nathanshaw/SNES_Circuit_Bending/README.md

Donkey KongCountry Circuit Bent

# SNES_Circuit_Bending
