nathanshaw/SNES_Circuit_Bending/snes_schematic_color.pdf

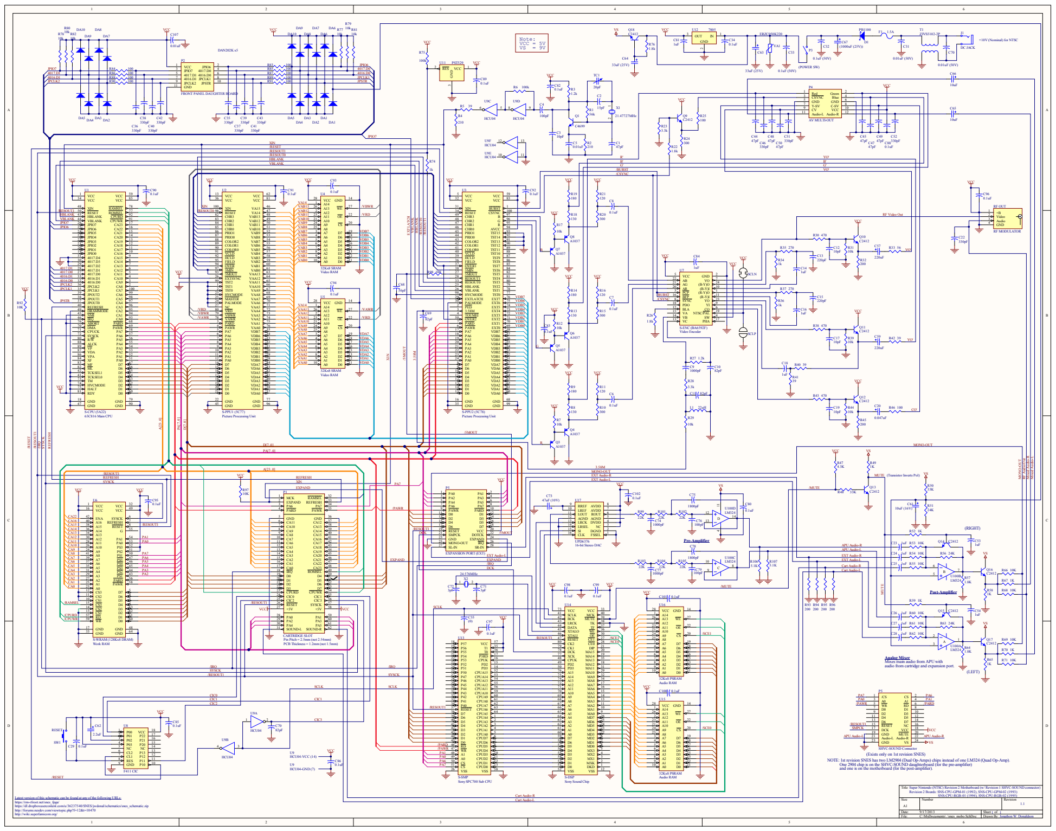
[picture p1: page 1]

Note:
+10V (Nominal) for NTSC VCC = aV VS = 9V

GND 11

FRONT PANEL DAUGHTER BOARD

CSYNC 3 Blue GND C-SV VCC Audio-R | 4
GND 5 | 6
Y-SV 7 | 8
CV 9 | 10
Audio-L 11 | 12

/RESET | | 10 11 U9E
/RESOUT1 | R74 1k
/RESOUT0

/CSYNC | RF Video Out

COLOR0 90 | VAB3 | A3 7 | VDB3

VCC | A[23..0] | MONO-OUT

R49 1K MUTE (Transistor Inverts Pol)

R71 10K Analog Mixer Mixes main audio from APU with audio from cartridge and expansion port.

SHVC-SOUND Connector
(Exists only on 1st revision SNES)

NOTE: 1st revision SNES has two LM2904 (Dual Op-Amps) chips instead of one LM324 (Quad Op-Amp). One 2904 chip is on the SHVC-SOUND daughterboard (for the pre-amplifier) and one is on the motherboard (for the post-amplifier).

Title
Super Nintendo (NTSC) Revision 2 Motherboard (w/ Revision 1 SHVC-SOUND connector)
Revision 2 Boards: SNS-CPU-GPM-01 (1992), SNS-CPU-GPM-02 (1993)

Latest version of this schematic can be found at any of the following URLs:
https://rm-rfroot.net/snes_fpga/
https://dl.dropboxusercontent.com/u/36237540/SNES/jwdonal/schematics/snes_schematic.zip
http://forums.nesdev.com/viewtopic.php?f=12at=10470
http://wiki.superfamicom.org/

SNS-CPU-RGB-01 (1994), SNS-CPU-RGB-02 (1995)
