nathanshaw/SNES_Circuit_Bending/CAD/modular_snes/nano_control_station.brd

## EAGLE design CAD/modular_snes/nano_control_station.brd (2015-11-13)

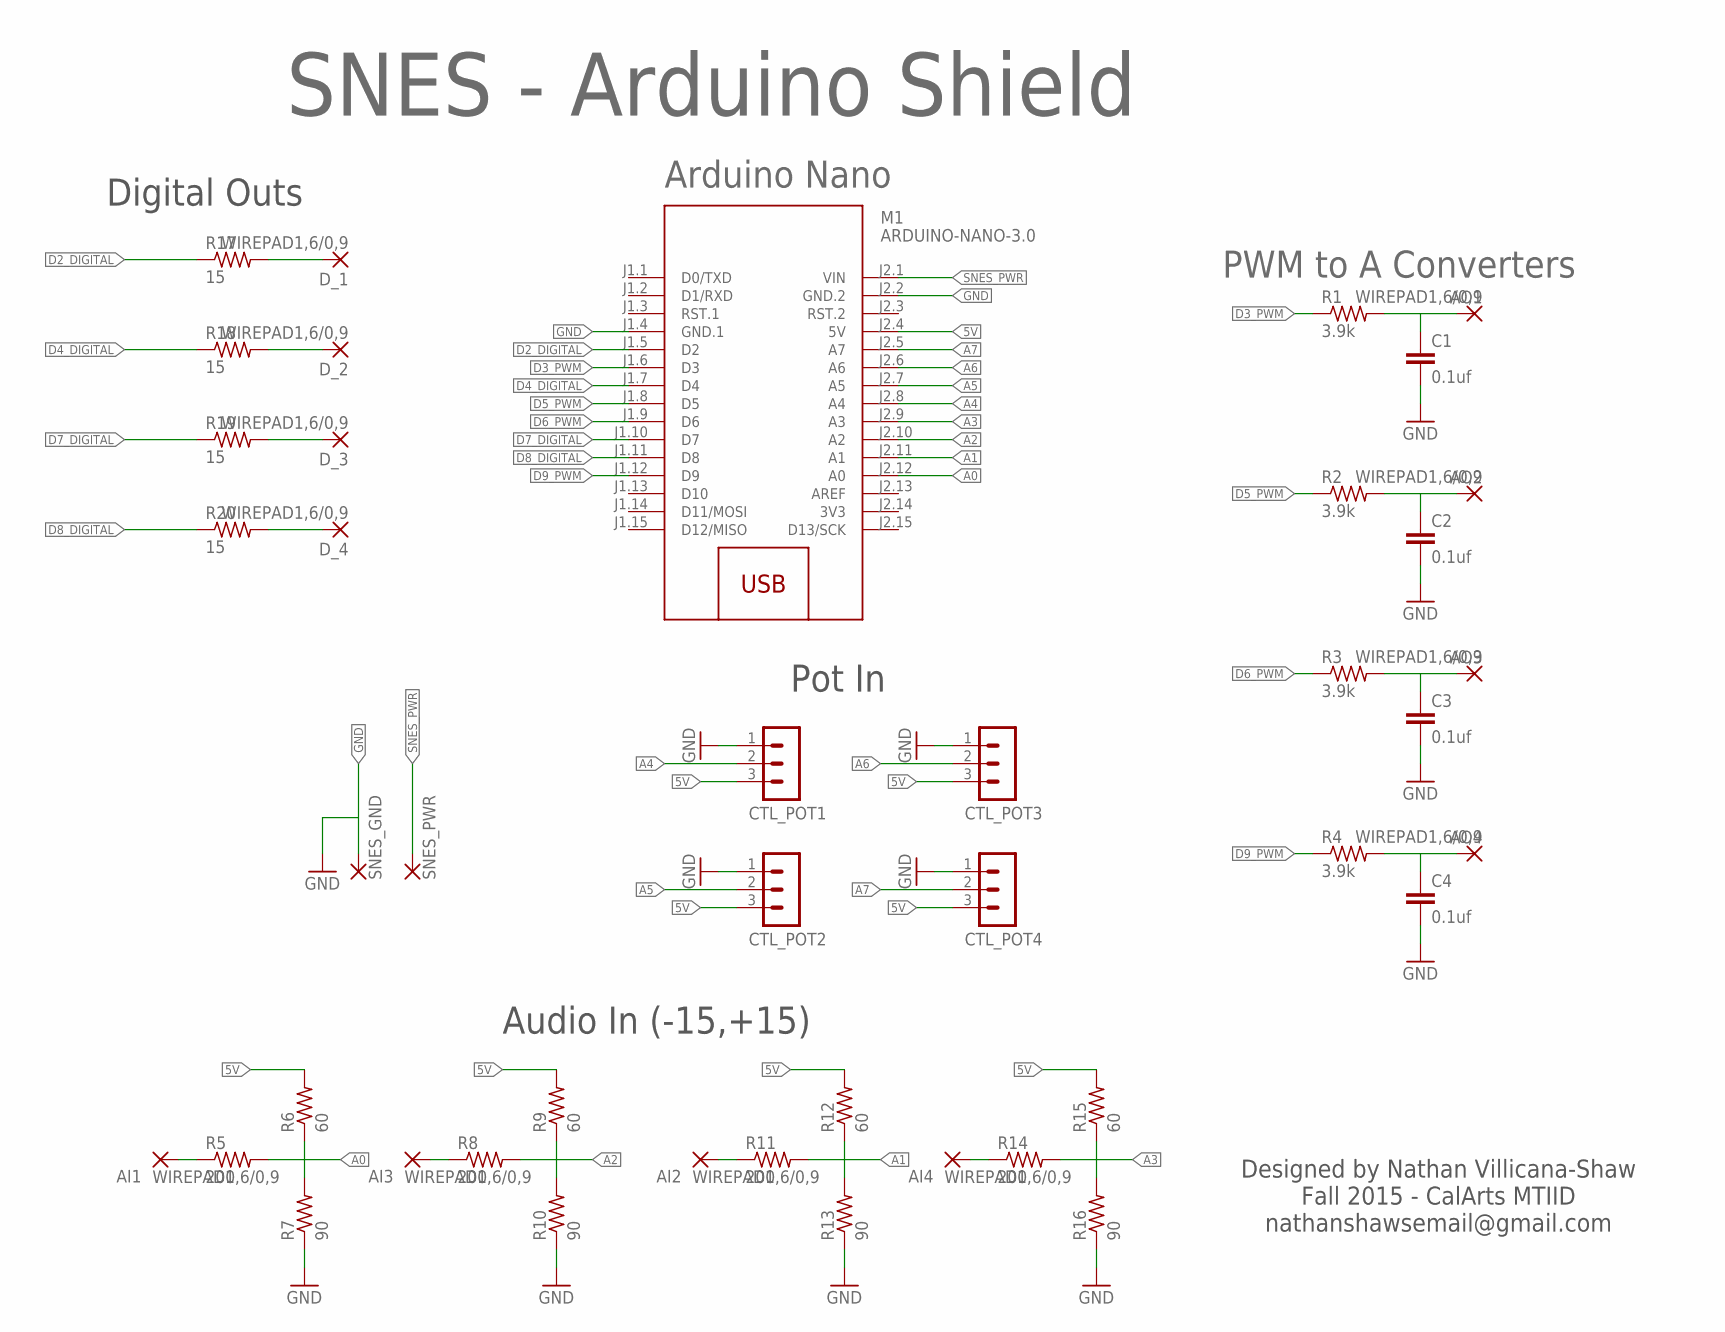
[picture p2: schematic nano_control_station.sch]

Parts:
AI1, AI2, AI3, AI4: WIREPAD1,6/0,9; 1,6/0,9
AO1, AO2, AO3, AO4: WIREPAD1,6/0,9; 1,6/0,9
C1, C2, C3, C4: 0.1uf; C2.5-2
CTL_POT1, CTL_POT2, CTL_POT3, CTL_POT4: MA03-1
D_1, D_2, D_3, D_4: WIREPAD1,6/0,9; 1,6/0,9
M1: ARDUINO-NANO-3.0
R1, R2, R3, R4: 3.9k; 0204/7
R5, R8, R11, R14: 200; 0204/7
R6, R9, R12, R15: 60; 0204/7
R7, R10, R13, R16: 90; 0204/7
R17, R18, R19, R20: 15; 0204/7
SNES_GND: 2,15/1,0
SNES_PWR: 2,15/1,0

Connections:
3V3: M1.J2.14 (3V3)
5V: CTL_POT1.3, CTL_POT2.3, CTL_POT3.3, CTL_POT4.3, M1.J2.4 (5V), R6.2, R9.2, R12.2, R15.2
A0: M1.J2.12 (A0), R5.2, R6.1, R7.2
A1: M1.J2.11 (A1), R11.2, R12.1, R13.2
A2: M1.J2.10 (A2), R8.2, R9.1, R10.2
A3: M1.J2.9 (A3), R14.2, R15.1, R16.2
A4: CTL_POT1.2, M1.J2.8 (A4)
A5: CTL_POT2.2, M1.J2.7 (A5)
A6: CTL_POT3.2, M1.J2.6 (A6)
A7: CTL_POT4.2, M1.J2.5 (A7)
D2_DIGITAL: M1.J1.5 (D2), R17.1
D3_PWM: M1.J1.6 (D3), R1.1
D4_DIGITAL: M1.J1.7 (D4), R18.1
D5_PWM: M1.J1.8 (D5), R2.1
D6_PWM: M1.J1.9 (D6), R3.1
D7_DIGITAL: M1.J1.10 (D7), R19.1
D8_DIGITAL: M1.J1.11 (D8), R20.1
D9_PWM: M1.J1.12 (D9), R4.1
GND: C1.2, C2.2, C3.2, C4.2, CTL_POT1.1, CTL_POT2.1, CTL_POT3.1, CTL_POT4.1, M1.J1.4 (GND.1), M1.J2.2 (GND.2), R7.1, R10.1, R13.1, R16.1, SNES_GND.1
unnamed: AI3.1, R8.1
unnamed: AO1.1, C1.1, R1.2
unnamed: AO2.1, C2.1, R2.2
unnamed: AO3.1, C3.1, R3.2
unnamed: AO4.1, C4.1, R4.2
unnamed: AI1.1, R5.1
unnamed: AI2.1, R11.1
unnamed: AI4.1, R14.1
unnamed: D_2.1, R18.2
unnamed: D_1.1, R17.2
unnamed: D_3.1, R19.2
unnamed: D_4.1, R20.2
SNES_PWR: M1.J2.1 (VIN), SNES_PWR.1

Notes on the sheet:
PWM to A Converters
Audio In (-15,+15)
Digital Outs
Pot In
Arduino Nano
SNES - Arduino Shield
Designed by Nathan Villicana-Shaw Fall 2015 - CalArts MTIID nathanshawsemail@gmail.com

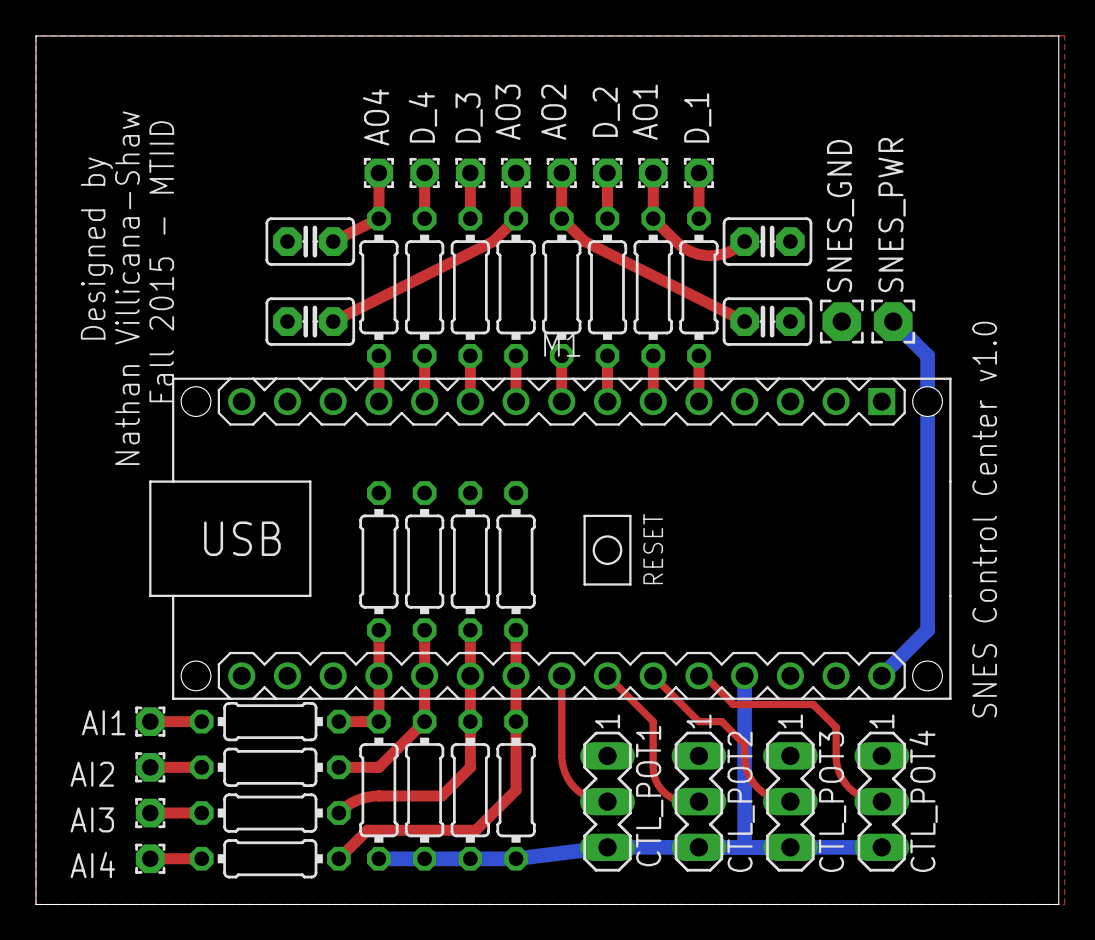
[picture p3: board nano_control_station.brd from above]

Board: 2 copper layers, 56.8 x 48.2 mm, 43 parts (0 on the bottom side), 31 nets.
