nathanshaw/SNES_Circuit_Bending/CAD/Ultimate_Co_Op_Mega_Shield/ultimate_Co-Op_v2_0.brd

## EAGLE design CAD/Ultimate_Co_Op_Mega_Shield/ultimate_Co-Op_v2_0.brd (2016-02-03)

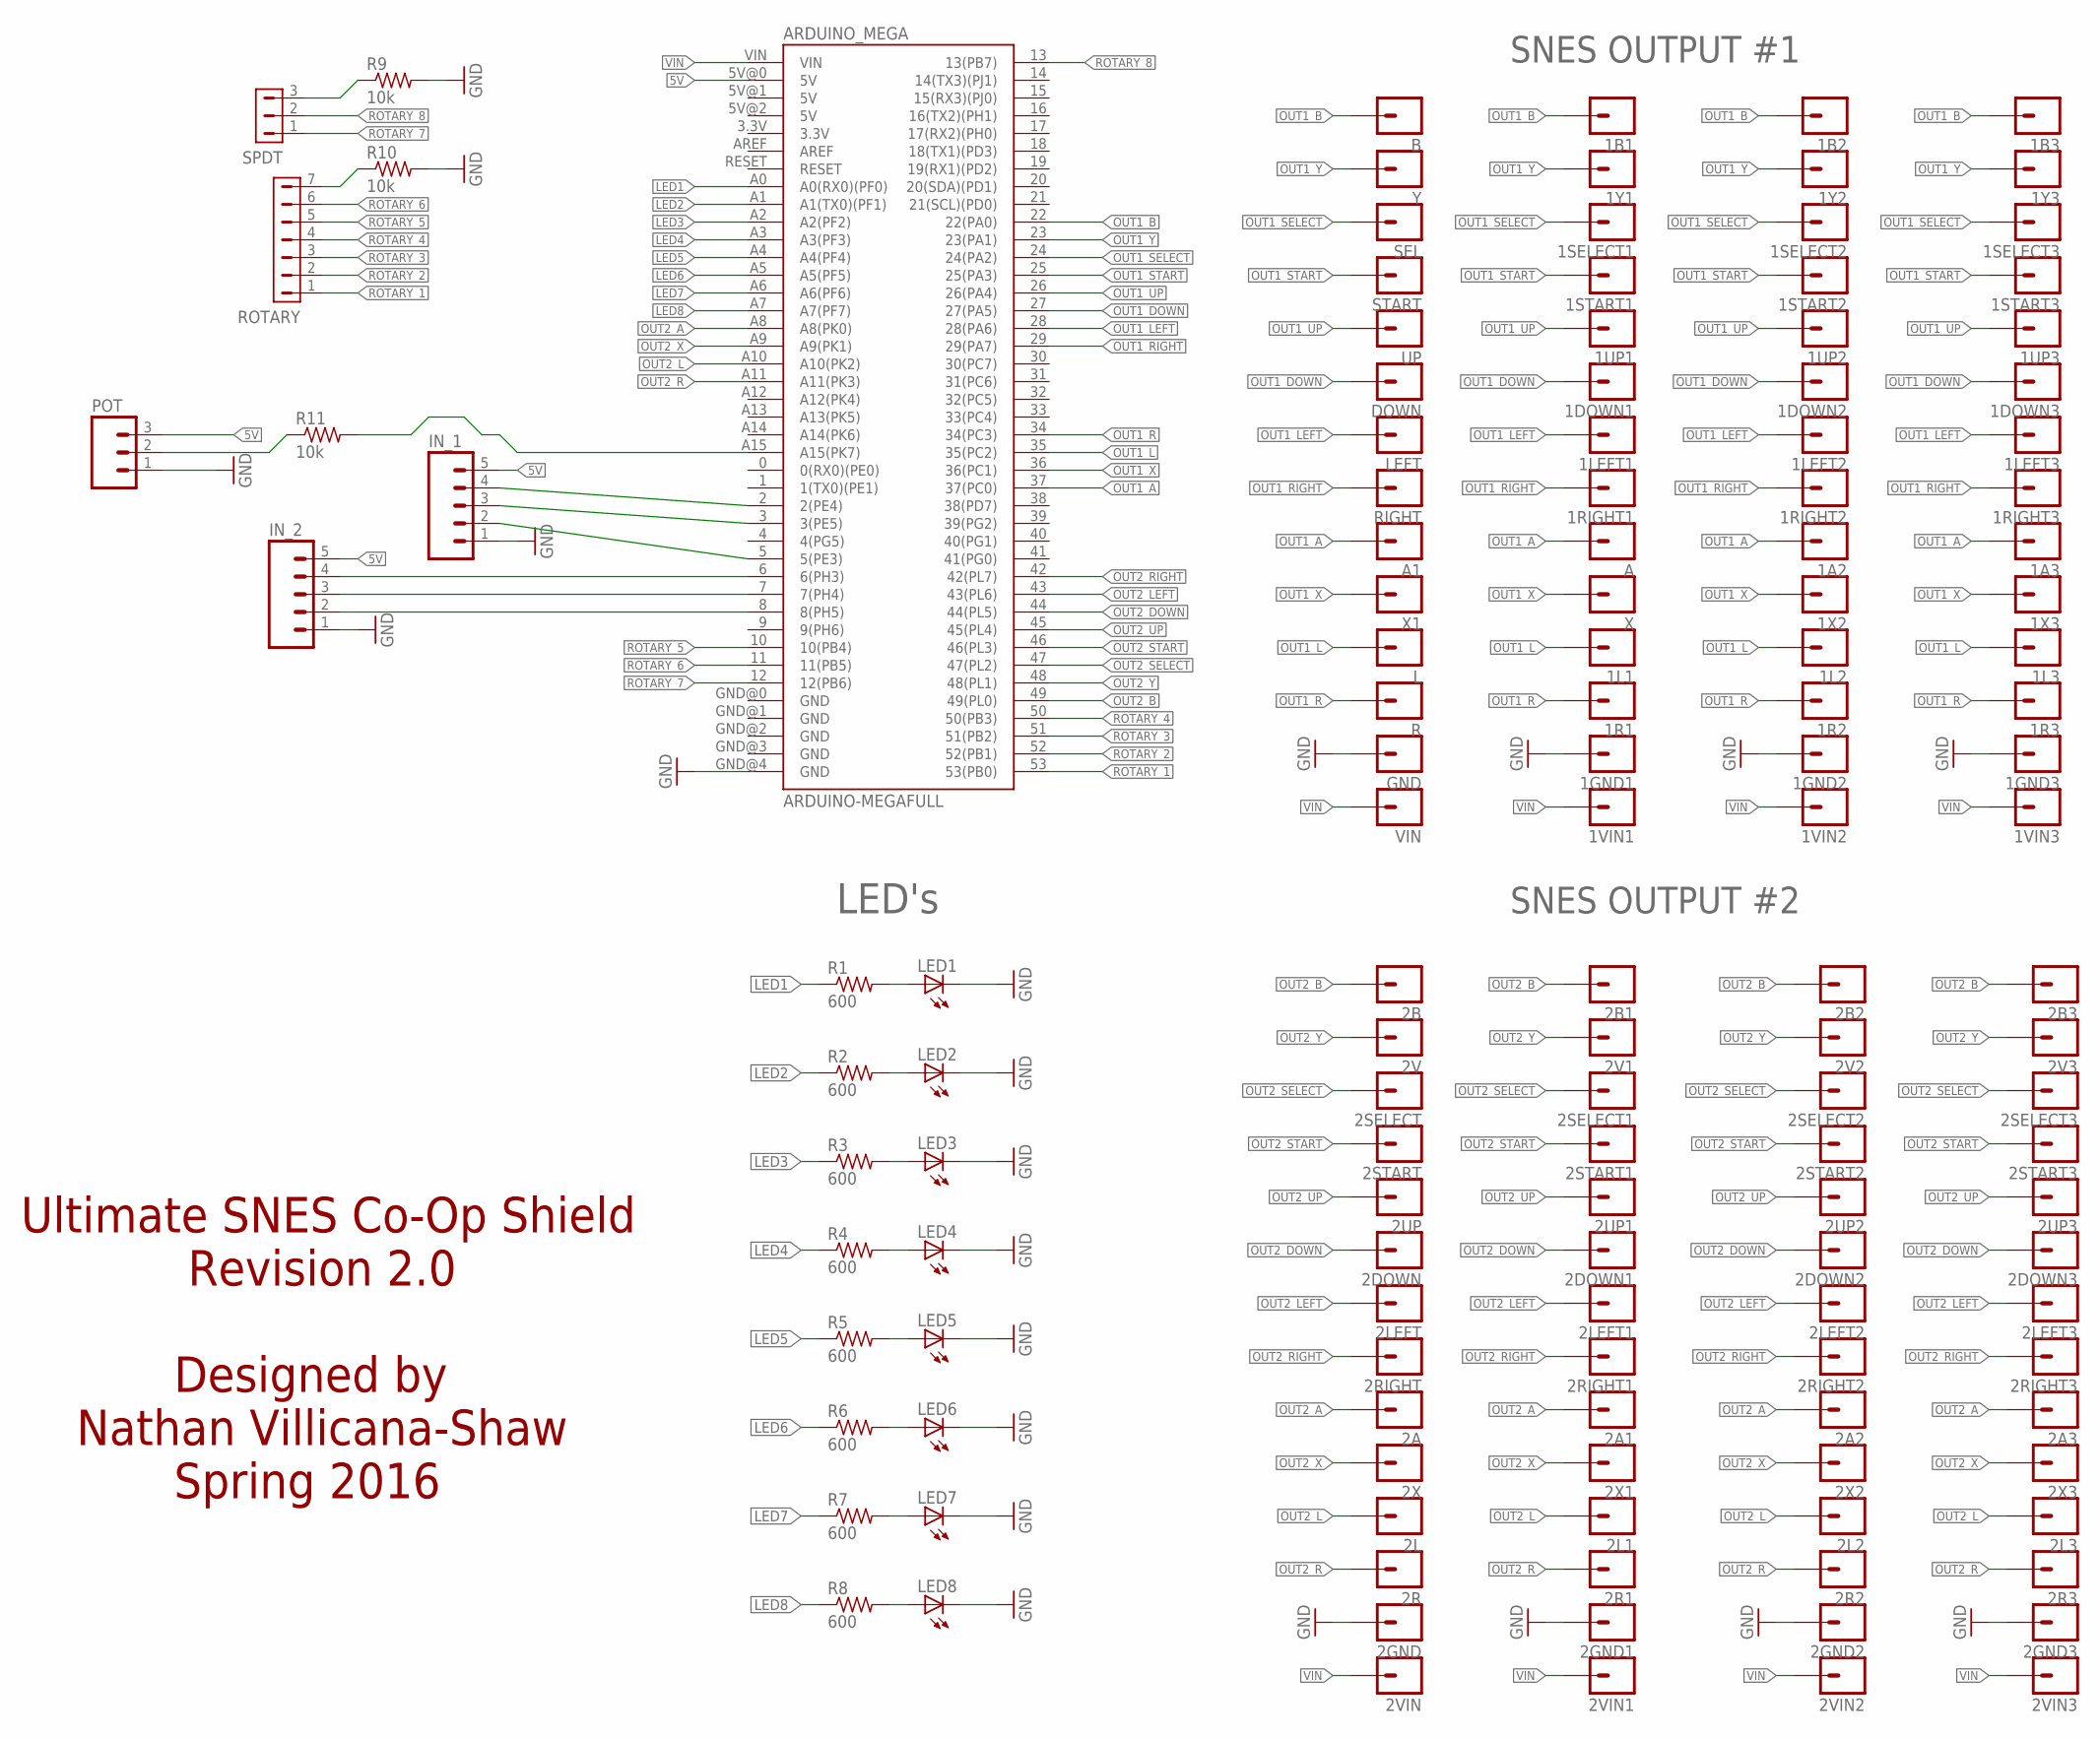
[picture p4: schematic ultimate_Co-Op_v2_0.sch]

Parts:
1A2, 1A3, 1B1, 1B2, 1B3, 1DOWN1, 1DOWN2, 1DOWN3, 1GND1, 1GND2, 1GND3, 1L1, 1L2, 1L3, 1LEFT1, 1LEFT2, 1LEFT3, 1R1, 1R2, 1R3, 1RIGHT1, 1RIGHT2, 1RIGHT3, 1SELECT1, 1SELECT2, 1SELECT3, 1START1, 1START2, 1START3, 1UP1, 1UP2, 1UP3, 1VIN1, 1VIN2, 1VIN3, 1X2, 1X3, 1Y1, 1Y2, 1Y3, 2A, 2A1, 2A2, 2A3, 2B, 2B1, 2B2, 2B3, 2DOWN, 2DOWN1, 2DOWN2, 2DOWN3, 2GND, 2GND1, 2GND2, 2GND3, 2L, 2L1, 2L2, 2L3, 2LEFT, 2LEFT1, 2LEFT2, 2LEFT3, 2R, 2R1, 2R2, 2R3, 2RIGHT, 2RIGHT1, 2RIGHT2, 2RIGHT3, 2SELECT, 2SELECT1, 2SELECT2, 2SELECT3, 2START, 2START1, 2START2, 2START3, 2UP, 2UP1, 2UP2, 2UP3, 2V, 2V1, 2V2, 2V3, 2VIN, 2VIN1, 2VIN2, 2VIN3, 2X, 2X1, 2X2, 2X3: M01PTH; 1X01
A, A1: M01PTH; 1X01
ARDUINO_MEGA: ARDUINO-MEGAFULL; ARDUINO_MEGA
B: M01PTH; 1X01
DOWN: M01PTH; 1X01
GND: M01PTH; 1X01
IN_1, IN_2: M05PTH; 1X05
L: M01PTH; 1X01
LED1, LED2, LED3, LED4, LED5, LED6, LED7, LED8: LED5MM
LEFT: M01PTH; 1X01
POT: M03LONGPADS; 1X03_LONGPADS
R: M01PTH; 1X01
R1, R2, R3, R4, R5, R6, R7, R8: 600; 0204/7
R9, R10, R11: 10k; 0204/7
RIGHT: M01PTH; 1X01
ROTARY: HDR-1X7-MTE-100; MTE-100-7V
SEL: M01PTH; 1X01
SPDT: HDR-1X3-MTA-100; MTA-100-3V
START: M01PTH; 1X01
UP: M01PTH; 1X01
VIN: M01PTH; 1X01
X, X1: M01PTH; 1X01
Y: M01PTH; 1X01

Connections:
5V: ARDUINO_MEGA.5V@0 (5V), IN_1.5, IN_2.5, POT.3
GND: 1GND1.1, 1GND2.1, 1GND3.1, 2GND.1, 2GND1.1, 2GND2.1, 2GND3.1, ARDUINO_MEGA.GND@4 (GND), GND.1, IN_1.1, IN_2.1, LED1.K (C), LED2.K (C), LED3.K (C), LED4.K (C), LED5.K (C), LED6.K (C), LED7.K (C), LED8.K (C), POT.1, R9.2, R10.2
LED1: ARDUINO_MEGA.A0 (A0(RX0)(PF0)), R1.1
LED2: ARDUINO_MEGA.A1 (A1(TX0)(PF1)), R2.1
LED3: ARDUINO_MEGA.A2 (A2(PF2)), R3.1
LED4: ARDUINO_MEGA.A3 (A3(PF3)), R4.1
LED5: ARDUINO_MEGA.A4 (A4(PF4)), R5.1
LED6: ARDUINO_MEGA.A5 (A5(PF5)), R6.1
LED7: ARDUINO_MEGA.A6 (A6(PF6)), R7.1
LED8: ARDUINO_MEGA.A7 (A7(PF7)), R8.1
LSJDFKS: ARDUINO_MEGA.6 (6(PH3)), IN_2.4
unnamed: LED1.A, R1.2
unnamed: LED2.A, R2.2
unnamed: LED3.A, R3.2
unnamed: LED4.A, R4.2
unnamed: LED5.A, R5.2
unnamed: LED6.A, R6.2
unnamed: LED7.A, R7.2
unnamed: LED8.A, R8.2
unnamed: ARDUINO_MEGA.2 (2(PE4)), IN_1.4
unnamed: ARDUINO_MEGA.3 (3(PE5)), IN_1.3
unnamed: ARDUINO_MEGA.5 (5(PE3)), IN_1.2
unnamed: ARDUINO_MEGA.A15 (A15(PK7)), R11.2
unnamed: ARDUINO_MEGA.7 (7(PH4)), IN_2.3
unnamed: ARDUINO_MEGA.8 (8(PH5)), IN_2.2
unnamed: POT.2, R11.1
OIJNENLK: R9.1, SPDT.3
OIJNENLK1: R10.1, ROTARY.7
OUT1_A: 1A2.1, 1A3.1, A.1, A1.1, ARDUINO_MEGA.37 (37(PC0))
OUT1_B: 1B1.1, 1B2.1, 1B3.1, ARDUINO_MEGA.22 (22(PA0)), B.1
OUT1_DOWN: 1DOWN1.1, 1DOWN2.1, 1DOWN3.1, ARDUINO_MEGA.27 (27(PA5)), DOWN.1
OUT1_L: 1L1.1, 1L2.1, 1L3.1, ARDUINO_MEGA.35 (35(PC2)), L.1
OUT1_LEFT: 1LEFT1.1, 1LEFT2.1, 1LEFT3.1, ARDUINO_MEGA.28 (28(PA6)), LEFT.1
OUT1_R: 1R1.1, 1R2.1, 1R3.1, ARDUINO_MEGA.34 (34(PC3)), R.1
OUT1_RIGHT: 1RIGHT1.1, 1RIGHT2.1, 1RIGHT3.1, ARDUINO_MEGA.29 (29(PA7)), RIGHT.1
OUT1_SELECT: 1SELECT1.1, 1SELECT2.1, 1SELECT3.1, ARDUINO_MEGA.24 (24(PA2)), SEL.1
OUT1_START: 1START1.1, 1START2.1, 1START3.1, ARDUINO_MEGA.25 (25(PA3)), START.1
OUT1_UP: 1UP1.1, 1UP2.1, 1UP3.1, ARDUINO_MEGA.26 (26(PA4)), UP.1
OUT1_X: 1X2.1, 1X3.1, ARDUINO_MEGA.36 (36(PC1)), X.1, X1.1
OUT1_Y: 1Y1.1, 1Y2.1, 1Y3.1, ARDUINO_MEGA.23 (23(PA1)), Y.1
OUT2_A: 2A.1, 2A1.1, 2A2.1, 2A3.1, ARDUINO_MEGA.A8 (A8(PK0))
OUT2_B: 2B.1, 2B1.1, 2B2.1, 2B3.1, ARDUINO_MEGA.49 (49(PL0))
OUT2_DOWN: 2DOWN.1, 2DOWN1.1, 2DOWN2.1, 2DOWN3.1, ARDUINO_MEGA.44 (44(PL5))
OUT2_L: 2L.1, 2L1.1, 2L2.1, 2L3.1, ARDUINO_MEGA.A10 (A10(PK2))
OUT2_LEFT: 2LEFT.1, 2LEFT1.1, 2LEFT2.1, 2LEFT3.1, ARDUINO_MEGA.43 (43(PL6))
OUT2_R: 2R.1, 2R1.1, 2R2.1, 2R3.1, ARDUINO_MEGA.A11 (A11(PK3))
OUT2_RIGHT: 2RIGHT.1, 2RIGHT1.1, 2RIGHT2.1, 2RIGHT3.1, ARDUINO_MEGA.42 (42(PL7))
OUT2_SELECT: 2SELECT.1, 2SELECT1.1, 2SELECT2.1, 2SELECT3.1, ARDUINO_MEGA.47 (47(PL2))
OUT2_START: 2START.1, 2START1.1, 2START2.1, 2START3.1, ARDUINO_MEGA.46 (46(PL3))
OUT2_UP: 2UP.1, 2UP1.1, 2UP2.1, 2UP3.1, ARDUINO_MEGA.45 (45(PL4))
OUT2_X: 2X.1, 2X1.1, 2X2.1, 2X3.1, ARDUINO_MEGA.A9 (A9(PK1))
OUT2_Y: 2V.1, 2V1.1, 2V2.1, 2V3.1, ARDUINO_MEGA.48 (48(PL1))
ROTARY_1: ARDUINO_MEGA.53 (53(PB0)), ROTARY.1
ROTARY_2: ARDUINO_MEGA.52 (52(PB1)), ROTARY.2
ROTARY_3: ARDUINO_MEGA.51 (51(PB2)), ROTARY.3
ROTARY_4: ARDUINO_MEGA.50 (50(PB3)), ROTARY.4
ROTARY_5: ARDUINO_MEGA.10 (10(PB4)), ROTARY.5
ROTARY_6: ARDUINO_MEGA.11 (11(PB5)), ROTARY.6
ROTARY_7: ARDUINO_MEGA.12 (12(PB6)), SPDT.1
ROTARY_8: ARDUINO_MEGA.13 (13(PB7)), SPDT.2
VIN: 1VIN1.1, 1VIN2.1, 1VIN3.1, 2VIN.1, 2VIN1.1, 2VIN2.1, 2VIN3.1, ARDUINO_MEGA.VIN, VIN.1

Notes on the sheet:
LED's
SNES OUTPUT #1
SNES OUTPUT #2
Ultimate SNES Co-Op Shield Revision 2.0 Designed by Nathan Villicana-Shaw Spring 2016

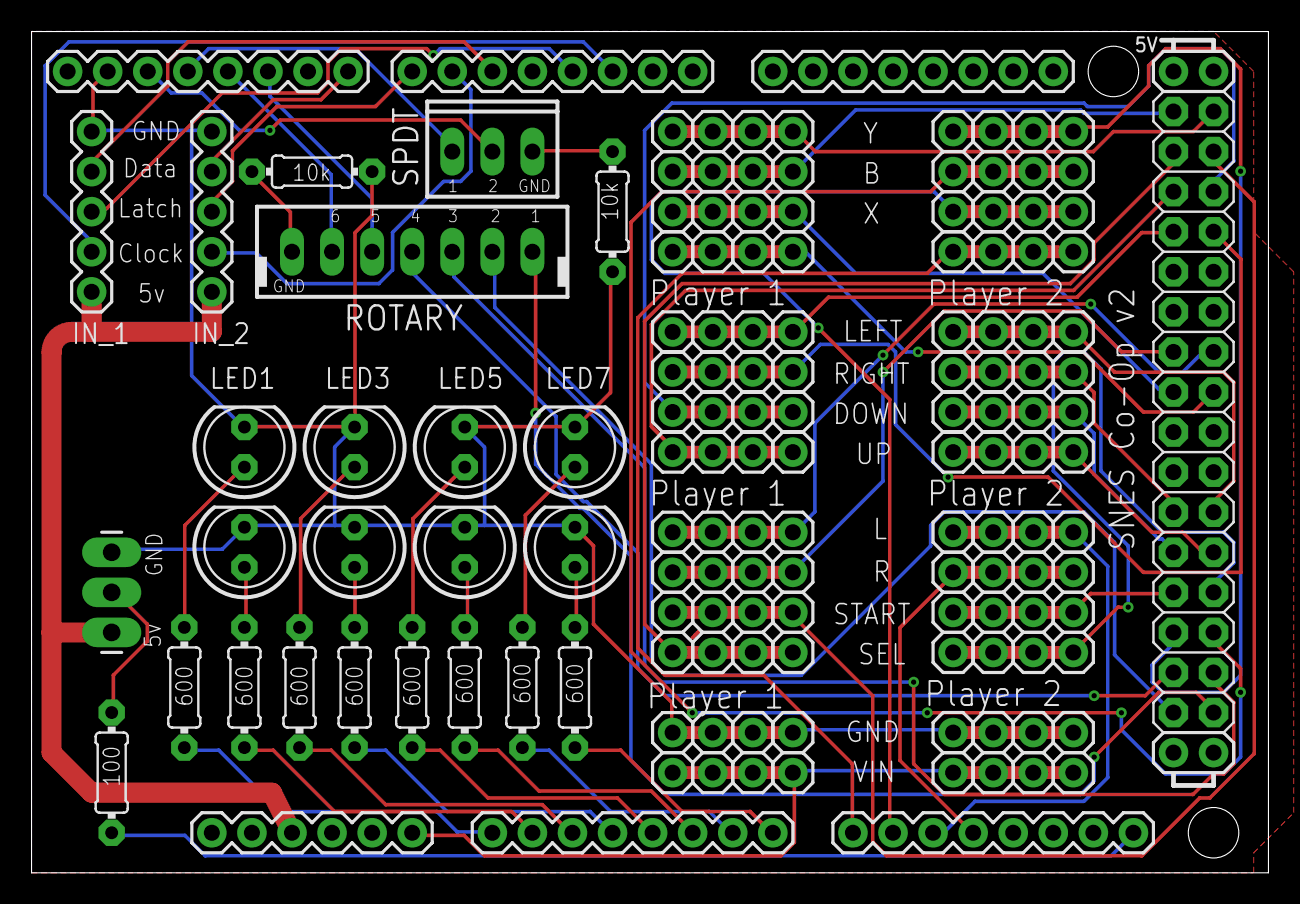
[picture p5: board ultimate_Co-Op_v2_0.brd from above]

Board: 2 copper layers, 78.4 x 53.3 mm, 137 parts (0 on the bottom side), 61 nets.
