nathanshaw/SNES_Circuit_Bending/CAD/Ultimate_Co_Op_Mega_Shield/ultimate_Co-Op_v1_0.brd

## EAGLE design CAD/Ultimate_Co_Op_Mega_Shield/ultimate_Co-Op_v1_0.brd (2016-01-06, an earlier design)

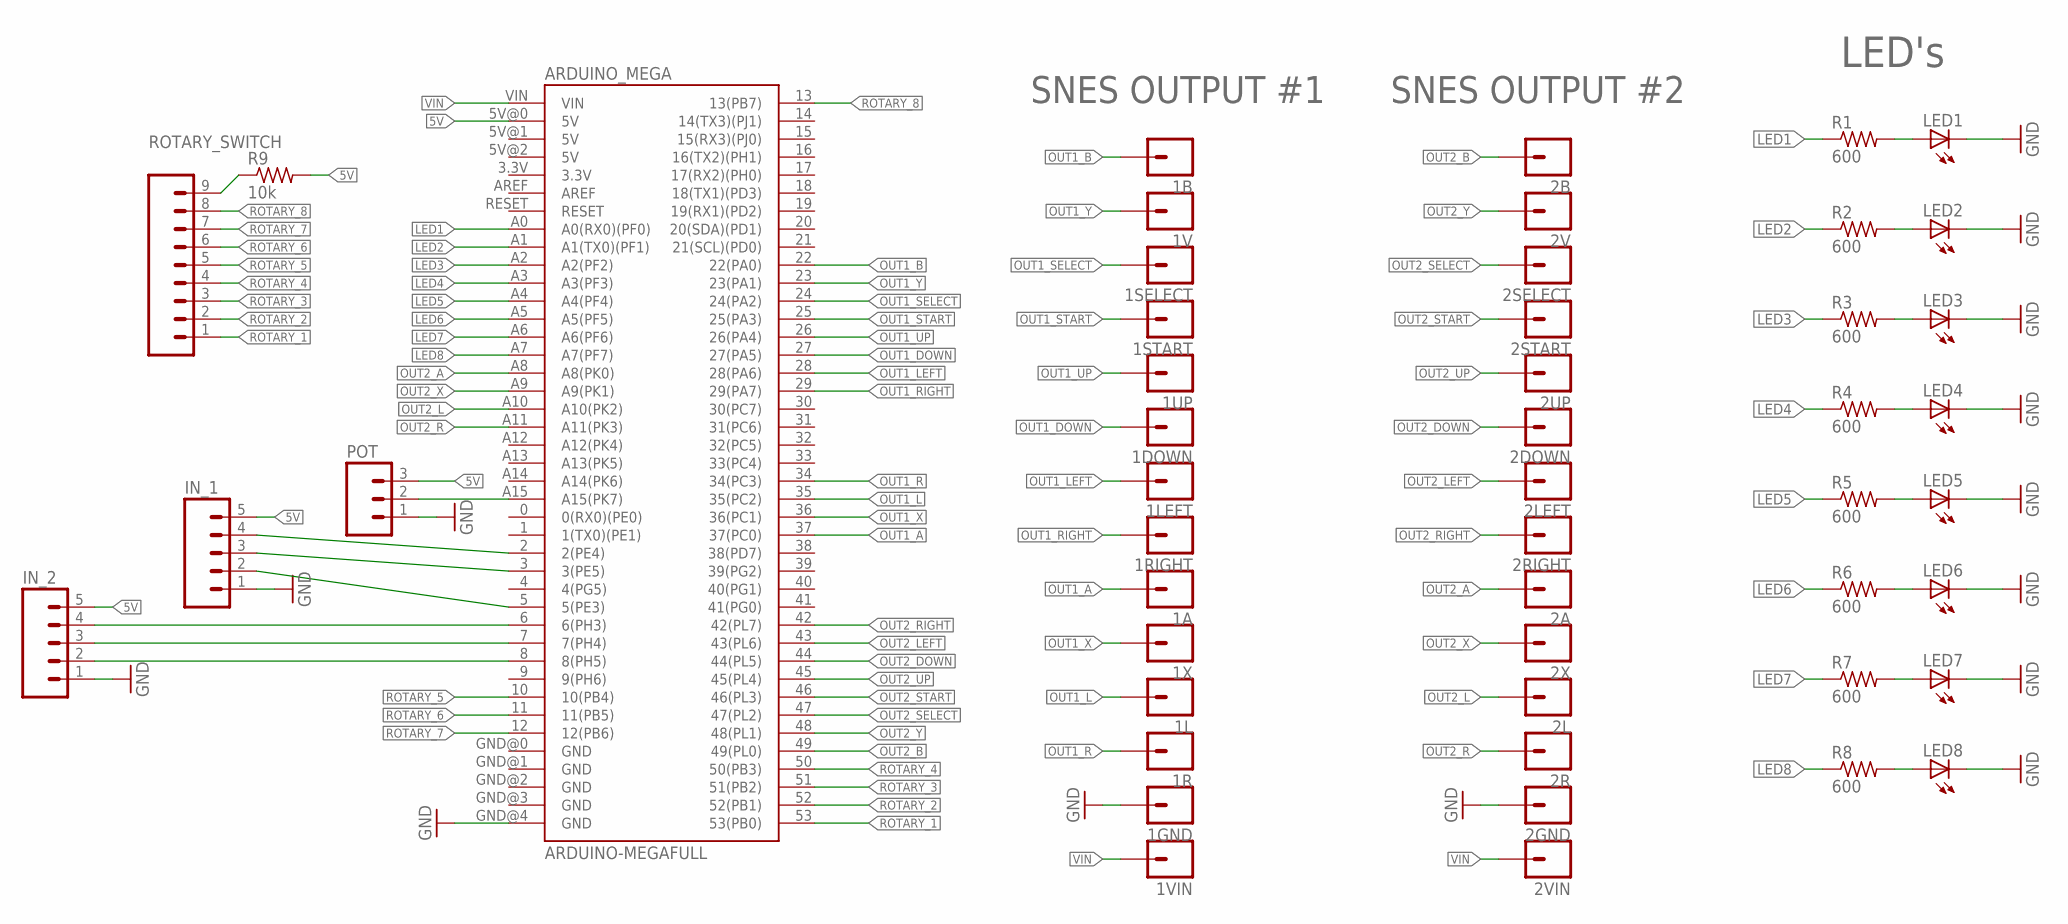
[picture p6: schematic ultimate_Co-Op_v1_0.sch]

Parts:
1A, 1B, 1DOWN, 1GND, 1L, 1LEFT, 1R, 1RIGHT, 1SELECT, 1START, 1UP, 1V, 1VIN, 1X, 2A, 2B, 2DOWN, 2GND, 2L, 2LEFT, 2R, 2RIGHT, 2SELECT, 2START, 2UP, 2V, 2VIN, 2X: M01PTH; 1X01
ARDUINO_MEGA: ARDUINO-MEGAFULL; ARDUINO_MEGA
IN_1, IN_2: M05PTH; 1X05
LED1, LED2, LED3, LED4, LED5, LED6, LED7, LED8: LED5MM
POT: M03LONGPADS; 1X03_LONGPADS
R1, R2, R3, R4, R5, R6, R7, R8: 600; 0204/7
R9: 10k; 0204/7
ROTARY_SWITCH: M09; 1X09

Connections:
5V: ARDUINO_MEGA.5V@0 (5V), IN_1.5, IN_2.5, POT.3, R9.2
GND: 1GND.1, 2GND.1, ARDUINO_MEGA.GND@4 (GND), IN_1.1, IN_2.1, LED1.K (C), LED2.K (C), LED3.K (C), LED4.K (C), LED5.K (C), LED6.K (C), LED7.K (C), LED8.K (C), POT.1
LED1: ARDUINO_MEGA.A0 (A0(RX0)(PF0)), R1.1
LED2: ARDUINO_MEGA.A1 (A1(TX0)(PF1)), R2.1
LED3: ARDUINO_MEGA.A2 (A2(PF2)), R3.1
LED4: ARDUINO_MEGA.A3 (A3(PF3)), R4.1
LED5: ARDUINO_MEGA.A4 (A4(PF4)), R5.1
LED6: ARDUINO_MEGA.A5 (A5(PF5)), R6.1
LED7: ARDUINO_MEGA.A6 (A6(PF6)), R7.1
LED8: ARDUINO_MEGA.A7 (A7(PF7)), R8.1
LSJDFKS: ARDUINO_MEGA.6 (6(PH3)), IN_2.4
unnamed: LED1.A, R1.2
unnamed: LED2.A, R2.2
unnamed: LED3.A, R3.2
unnamed: LED4.A, R4.2
unnamed: LED5.A, R5.2
unnamed: LED6.A, R6.2
unnamed: LED7.A, R7.2
unnamed: LED8.A, R8.2
unnamed: ARDUINO_MEGA.2 (2(PE4)), IN_1.4
unnamed: ARDUINO_MEGA.3 (3(PE5)), IN_1.3
unnamed: ARDUINO_MEGA.5 (5(PE3)), IN_1.2
unnamed: ARDUINO_MEGA.7 (7(PH4)), IN_2.3
unnamed: ARDUINO_MEGA.8 (8(PH5)), IN_2.2
OIJNENLK: R9.1, ROTARY_SWITCH.9
OUT1_A: 1A.1, ARDUINO_MEGA.37 (37(PC0))
OUT1_B: 1B.1, ARDUINO_MEGA.22 (22(PA0))
OUT1_DOWN: 1DOWN.1, ARDUINO_MEGA.27 (27(PA5))
OUT1_L: 1L.1, ARDUINO_MEGA.35 (35(PC2))
OUT1_LEFT: 1LEFT.1, ARDUINO_MEGA.28 (28(PA6))
OUT1_R: 1R.1, ARDUINO_MEGA.34 (34(PC3))
OUT1_RIGHT: 1RIGHT.1, ARDUINO_MEGA.29 (29(PA7))
OUT1_SELECT: 1SELECT.1, ARDUINO_MEGA.24 (24(PA2))
OUT1_START: 1START.1, ARDUINO_MEGA.25 (25(PA3))
OUT1_UP: 1UP.1, ARDUINO_MEGA.26 (26(PA4))
OUT1_X: 1X.1, ARDUINO_MEGA.36 (36(PC1))
OUT1_Y: 1V.1, ARDUINO_MEGA.23 (23(PA1))
OUT2_A: 2A.1, ARDUINO_MEGA.A8 (A8(PK0))
OUT2_B: 2B.1, ARDUINO_MEGA.49 (49(PL0))
OUT2_DOWN: 2DOWN.1, ARDUINO_MEGA.44 (44(PL5))
OUT2_L: 2L.1, ARDUINO_MEGA.A10 (A10(PK2))
OUT2_LEFT: 2LEFT.1, ARDUINO_MEGA.43 (43(PL6))
OUT2_R: 2R.1, ARDUINO_MEGA.A11 (A11(PK3))
OUT2_RIGHT: 2RIGHT.1, ARDUINO_MEGA.42 (42(PL7))
OUT2_SELECT: 2SELECT.1, ARDUINO_MEGA.47 (47(PL2))
OUT2_START: 2START.1, ARDUINO_MEGA.46 (46(PL3))
OUT2_UP: 2UP.1, ARDUINO_MEGA.45 (45(PL4))
OUT2_X: 2X.1, ARDUINO_MEGA.A9 (A9(PK1))
OUT2_Y: 2V.1, ARDUINO_MEGA.48 (48(PL1))
POT1: ARDUINO_MEGA.A15 (A15(PK7)), POT.2
ROTARY_1: ARDUINO_MEGA.53 (53(PB0)), ROTARY_SWITCH.1
ROTARY_2: ARDUINO_MEGA.52 (52(PB1)), ROTARY_SWITCH.2
ROTARY_3: ARDUINO_MEGA.51 (51(PB2)), ROTARY_SWITCH.3
ROTARY_4: ARDUINO_MEGA.50 (50(PB3)), ROTARY_SWITCH.4
ROTARY_5: ARDUINO_MEGA.10 (10(PB4)), ROTARY_SWITCH.5
ROTARY_6: ARDUINO_MEGA.11 (11(PB5)), ROTARY_SWITCH.6
ROTARY_7: ARDUINO_MEGA.12 (12(PB6)), ROTARY_SWITCH.7
ROTARY_8: ARDUINO_MEGA.13 (13(PB7)), ROTARY_SWITCH.8
VIN: 1VIN.1, 2VIN.1, ARDUINO_MEGA.VIN

Notes on the sheet:
LED's
SNES OUTPUT #1
SNES OUTPUT #2

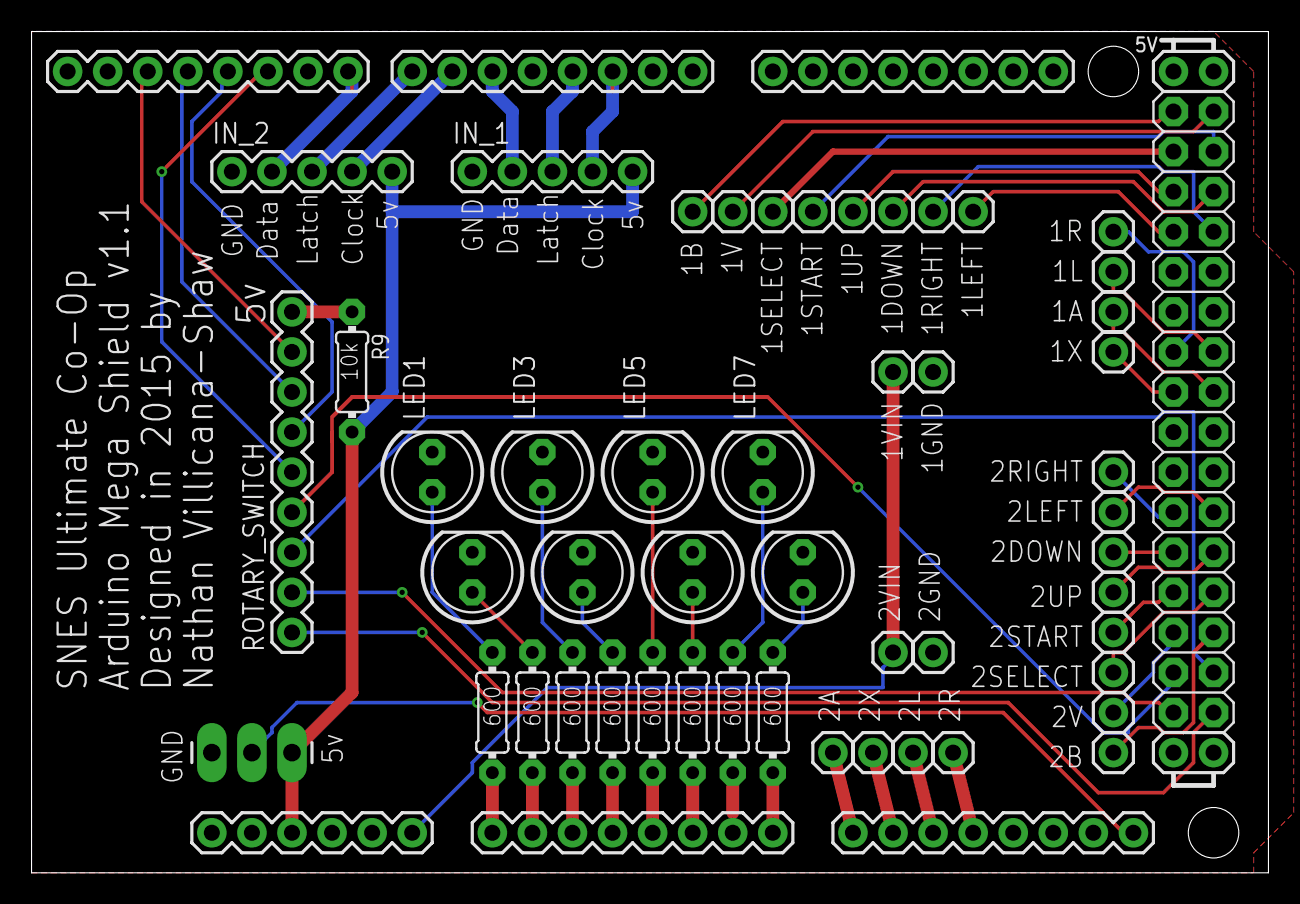
[picture p7: board ultimate_Co-Op_v1_0.brd from above]

Board: 2 copper layers, 78.4 x 53.3 mm, 50 parts (0 on the bottom side), 59 nets.
