nathanshaw/SNES_Circuit_Bending/Firmware/ultimate_co_op_Single_mode/ultimate_co_op_Single_mode.ino

/*
    Arduino Firmware for interfacing with the SNES

    Two Input Controllers : Two Output Controllers

    Programmed by Nathan Villicana-Shaw
    Fall 2015

    This project is a work in progress and builds upon the shoulders
    of many brilliant programmers, hackers, engineers and artists
    (links to be added soon)

    This specific version is for use with the Arduino Shield V1.1
    All the pinouts used in this configuration will be inside the () next to
    the normal values


    ===========================================================
    ARDUINO : PORTS AND PINS
    ===========================================================

    -------------------------------------------------
    PLAYER 1 : INPUT
    -------------------------------------------------
    GND
    5v
    DATA          5
    LATCH         3
    CLOCK         2
    -------------------------------------------------
    PLAYER 2 : INPUT
    -------------------------------------------------
    GND
    5v
    DATA          8
    LATCH         7
    CLOCK         6
    -------------------------------------------------
    PLAYER 1 : OUTPUT
    -------------------------------------------------
    PORTA on the Arduino Mega consists of pins 22-29
      22 is bit 0, 29 is bit 7
      we use all the pins  (11111111)

    PORTC on the Arduino MEGA consists of pins 30-37
    `37 is bit 0, 30 is bit 7
      we use pins 34-37 (xxxx1111)

    --------------------------------------------------
    PLAYER 2 : OUTPUT
    -------------------------------------------------
    PORTL : on the Arduino Mega consists of pins 42-49
      49 is bit 0, 42 is bit 7
      we use all the pins (11111111)

    PORTK : on the Arduino Mega consists of analog pins a8-a15
      a8 is bit 0, a15 is bit 7
      we use pins a8-a15 (xxxx1111)

    --------------------------------------------------
    LEDS :
    --------------------------------------------------
    PORTF : on the Arduno Mega port F consists of analog
      pins 0 - 7, each LED corrisponds with an operation mode

    ================================================================================
                                  SNES CONTROLLERS
    ================================================================================

    It is very important to note that the SNES controller reads a button as being pressed
    upon the grounding of its corrisponding pin -  Thus when a 0 is written to a Pin the
    button is "pressed" until the pin is raised back to its HIGH

    When hooking up the SNES controllers there are a few things that help the process :

                  SNES Controller Jack Pins
     ----------------------------- ---------------------
    |                             |                      \
    | (1)     (2)     (3)     (4) |   (5)     (6)     (7) |
    |                             |                      /
     ----------------------------- ---------------------

    Pin   Description   Wire Color(OEM)  Wire Color(controller extenders)
    ===   ===========   ==============   ==================
     1    +5v (power)   White            Blue
     2    Clock         Yellow           Yellow
     3    Latch         Orange           Black
     4    Data          Red              Red
     5    Nothing       None             None
     6    Nothing       None             None
     7    Ground        Brown            Green

     Data Packing Order for the buttons. Note that the first clock cycle
     is acutually the downwards edge of the LATCH

     Clock Cycle     Button Reported          MEGA PIN Player 1         MEGA PIN Player 2
     ===========     ===============          =================         =================
        1               B                           22                          49
        2               Y                           23                          48
        3               Select                      24                          47
        4               Start - down                25                          46
        5               Up on joypad                26                          45
        6               Down on joypad              27                          44
        7               Left on joypad              28                          43
        8               Right on joypad             29                          42
        9               A                           37                          A8
        10              X                           36                          A9
        11              L                           35                          A10
        12              R                           34                          A11
        13              none (always high)         none                        none
        14              none (always high)         none                        none
        15              none (always high)         none                        none
        16              none (always high)         none                        none

      =======================================================================
                            Mode Selection
      =======================================================================

      Mode selection is determined by the position of the rotary switch as well as the position of the toggle switch.

      =======================================================================
                                      LEDS
      =======================================================================
      for expandability and to allow for all the currently available modes of operation
      different color LEDS will be used to help provide more meaningful user feedback
      Control for 8LED's total is provided by the shield

        LED Num          LED Color          Meaning
       (on Board)

          1                 Red             If on it Denotes a VS mode
          2                 Blue            If on it Denotes a Co-Op Mode
          3                 Green           xxxxx
          4                 Green           xxxxx
          5                 Green           xxxxx
          6                 Green           xxxxx
          7                 Green           xxxxx
          8                 Green           xxxxx

      If you want to play normal without any interfierence from the interface turn the switch off

      All of the LEDS will flash when the game is in the selection mode

      =======================================================================
                                    General Notes
      =======================================================================

      For the SNES controllers the buttons resting position is HIGH as 5v when
      the pad is grounded the button is pressed. This is usally done by bridging
      pads together using conductive plastic that rests on the bottom of the button
      you pressed. In this project we solder wires to the sensing pads that we ground
      using our arduinos digital pins.

      TODO ::

      Flushout the player takeover system
        - perhaps the buttons become the other players D-pad?

       Have different color LEDS for 'single player' and multiplayer modes

       Add logic for the pot: change turn length, and other things
*/

// ================================================================
//                           Preprocessor
// ================================================================

#include <SNESpad.h>

// the pins we use for receiving data from the two SNES controllers

// --------------------- Arduino Pins ------------------------

#define SHIELD_VERSION 2 // 0 is no shield proto, 1 is v1 of shield, 2 is v1.1 of shield

#if SHIELD_VERSION == 2
#define IN1_LATCH 3
#define IN1_CLOCK 2
#define IN1_DATA 5
#define IN2_LATCH 7
#define IN2_CLOCK 6
#define IN2_DATA 8
#define POT_SIG A15
#endif

#if SHIELD_VERSION == 1
#define IN1_LATCH 12
#define IN1_CLOCK 13
#define IN1_DATA 11
#define IN2_LATCH 50
#define IN2_CLOCK 10
#define IN2_DATA 51
#define POT_SIG A15
#endif

#if SHIELD_VERSION == 0
#define IN1_LATCH 2
#define IN1_CLOCK 3
#define IN1_DATA 4
#define IN2_LATCH 5
#define IN2_CLOCK 6
#define IN2_DATA 7
#define POT_SIG A15
#endif

// --------------------- PORTS -----------------------------

#define PLAYER1_BUTTONS1 PORTA
#define PLAYER1_BUTTONS2 PORTC
#define PLAYER2_BUTTONS1 PORTL
#define PLAYER2_BUTTONS2 PORTK
#define ROTARY_AND_SWITCH PORTB
#define STATUS_LEDS PORTF

// --------------------- MASKS -------------------------------

#define MODE_SELECT_MASK 0x0F03
#define TRIGGER_MASK 0xC00 //bitmask for both of the triggers
#define TRIGGER_MASK1 0xC00 //bitmask for both of the triggers

// ------------------------ MODES ----------------------------
//-----------  single player --------------------------------
#define SP_BOTH_CONTROL 0x06          // (OR) both players signal gets passed w/o resistance
#define SP_TEAMWORK 0x0A              // (AND) both players have to press a button
#define SP_AGREE 0x12                 // (XOR) if both players press a button it does not go through
#define SP_ALTERNATE 0x22             // players take turns of random length
#define SP_ALTERNATE_PRESSES 0x42     // (XOR) messages only pass if it is not present in both controllers
#define SP_TAKE_CONTROL 0x82          // players take turns

// ------------ Multiplayer ----------------------------------
#define MP_PRESSED_FIRST 0x05      // both controllers are passes as normal
#define MP_LIMITED_PRESS 0x09      // both controllers are passes as normal
#define MP_XOR 0x11                // (XOR) if both players press a button it does not go through
#define MP_TAKE_CONTROL 0x21       // by pressing both triggers you switch the character you are controllling
#define MP_ALTERNATE_CONTROL 0x41  // players alternate whom controls both characters
#define MP_BOTH_CONTROL 0x81       // both players control both characters, really silly

// --------------------- Controlers and Players -------------------

#define PLAYER_ONE 1
#define PLAYER_TWO 2

// ================================================================
//                            Globals
// ================================================================

// uint8_t MODE = SP_TEAMWORK;
// uint8_t MODE = SP_BOTH_CONTROL;
uint8_t MODE = SP_AGREE;
// uint8_t MODE = SP_ALTERNATE;
// uint8_t MODE = SP_ALTERNATE_PRESSES;

uint16_t potVal = 500;
bool outputsSwitched;

// for dev and debug
uint8_t DEBUG = 5;
uint16_t debugLength = 100;
uint64_t lastDebug = 0;
/*
   0 is no DEBUG
   1 is regular DEBUG - adds print statements
   2 is same as 1 but adds delay to program
*/

// dealing with which player is active as well
uint8_t activePlayer = PLAYER_ONE;
uint64_t turnStart = 0;
uint16_t turnLength = 0;
uint8_t turnLengthScaler = 4;

// LED flashing
uint64_t lastLedBlink;

// to keep track of last output states
uint16_t p1LastOutputState = 0x0FFF;
uint16_t p1OutputState = 0x0000;
uint16_t p2LastOutputState = 0x0FFF;
uint16_t p2OutputState = 0x0000;

// past button states
uint16_t player1State = 0x0000;
uint16_t player2State = 0x0000;

// VARIABLES Specific to Certain Modes

// ALTERNATE_PRESSES play modes
uint16_t maxPresses;

// TEAMWORK mode
uint8_t simPress;
uint16_t p1OutputMask, p2OutputMask;
uint16_t p1LastOutputMask, p2LastOutputMask;
uint64_t p1LastTrigger;
uint64_t p2LastTrigger;
uint16_t triggerDebouce = 1000;

// LIMITED PRESS
uint16_t p1Presses, p2Presses;
uint64_t lastPressCycle;
bool p1Does;
bool p2Does;

// XOR
uint16_t temp_mask, temp1, temp2;

// create instances of our SNES controller reader objects
SNESpad snes1 = SNESpad(IN1_LATCH, IN1_CLOCK, IN1_DATA);
SNESpad snes2 = SNESpad(IN2_LATCH, IN2_CLOCK, IN2_DATA);

// =================================================================
//                      Setup and Loop
// =================================================================

void setup() {
  // set controller ports to outputs
  DDRA = 0xFF;
  DDRC = 0xFF;
  DDRL = 0xFF;
  DDRK = 0xFF;
  // set LED's port to output
  DDRF = 0xFF;
  // turn on pullup resistors for rotary
  ROTARY_AND_SWITCH = 0xFF;
  // set the ROTARY INS as inputs
  DDRB = 0x00;

  pinMode(POT_SIG, INPUT);
  // set controller ports to HIGH (the resting state)
  PLAYER1_BUTTONS1 = 0xFF;
  PLAYER1_BUTTONS2 = 0xFF;
  PLAYER2_BUTTONS1 = 0xFF;
  PLAYER2_BUTTONS2 = 0xFF;
  // set LED's port to LOW
  STATUS_LEDS = 0x00;

  delay(10);
  Serial.begin(57600);
  Serial.println("SERIAL BUS OPENED");
}

void loop() {
  switch (MODE) {
    case SP_BOTH_CONTROL:
      spBothControl();
      break;

    case SP_AGREE:
      spPlayersAgree();
      break;

    case SP_ALTERNATE:
      spPlayersAlternate(turnLength);
      break;

    case SP_TAKE_CONTROL:
      spTakeControl();
      break;

    case SP_ALTERNATE_PRESSES:
      spAlternatePresses();
      break;

    case SP_TEAMWORK:
      spTeamwork();
      break;

    case MP_PRESSED_FIRST:
      mpPressedFirst();
      break;

    case MP_LIMITED_PRESS:
      mpLimitedPress();
      break;

    case MP_XOR:
      mpXOR();
      break;

    case MP_TAKE_CONTROL:
      mpTakeControl();
      break;

    case MP_ALTERNATE_CONTROL:
      // mpAlternateControl();
      break;

    case MP_BOTH_CONTROL:
      mpBothControl();
      break;
  }
  flashLeds();
  mainLoopDebug();
}

// ==========================================================================
//                    Single PLayer Modes of Operation
// ==========================================================================

void spTeamwork() {

  p1LastOutputState = p1OutputState;
  p2LastOutputState = p2OutputState;
  p1OutputState = snes1.buttons();
  p2OutputState = snes2.buttons();

  if (p1OutputState ^ p1LastOutputState != 0 && p1OutputState > p1LastOutputState) {
    p1LastOutputMask = p1OutputMask;
    p1OutputMask = (p1OutputState ^ p1LastOutputState);
    if (countBits(p1OutputMask) > 1) {
      p1OutputMask = buttonSettle(p1OutputMask ^ p1LastOutputMask);
    }
  }
  else if (p1OutputState ^ p1LastOutputState > 0) {
    if (countBits(p1OutputState) < countBits(p1LastOutputState)) {
      if (p1LastOutputMask & p1OutputState == 0) {
        p1OutputMask = buttonSettle(p1OutputState);
      }
      else {
        p1OutputMask = buttonSettle(p1LastOutputMask);
      }
      p1LastOutputMask = p1OutputMask;
    }
  }
  if (p2OutputState ^ p2LastOutputState != 0 && p2OutputState > p2LastOutputState) {
    p2LastOutputMask = p2OutputMask;
    p2OutputMask = (p2OutputState ^ p2LastOutputState);
    if (countBits(p2OutputMask) > 1) {
      p2OutputMask = buttonSettle(p2OutputMask ^ p2LastOutputMask);
    }
  }
  else if (p2OutputState ^ p2LastOutputState > 0) {
    if (countBits(p2OutputState) < countBits(p2LastOutputState)) {
      if (p2LastOutputMask & p2OutputState == 0) {
        p2OutputMask = buttonSettle(p2OutputState);
      }
      else {
        p2OutputMask = buttonSettle(p2LastOutputMask);
      }
      p2LastOutputMask = p2OutputMask;
    }
  }
  // the AND must not be directly applied to the p1OutputState else algorithm will fail
  writeToChip(p1OutputState | p2OutputState, p2OutputState | p1OutputState);
  dprintState("SP TEAMWORK :", p1OutputState, p2OutputState);
}

void spAlternatePresses() {
  p1OutputState = snes1.buttons();
  p2OutputState = snes2.buttons();
  static uint16_t press_count;
  maxPresses = (int)(potVal / 15);
  if (press_count > maxPresses) {
    activePlayer = (activePlayer + 1) % 2;
    press_count = 0;
  }
  if (activePlayer == 0) {
    if (p1OutputState > p1LastOutputState) {
      press_count++;
    }
    p2OutputState = p1OutputState;
  }
  else if (activePlayer == 1) {
    if (p2OutputState > p2LastOutputState) {
      press_count++;
    }
    p1OutputState = p2OutputState;
  }
  writeToChip(p1OutputState, p2OutputState);
  dprintln(" ");
  dprint(press_count);
  dprint("/");
  dprint(maxPresses);
  dprint(" ");
  dprint(activePlayer);
  dprintState(" SP ALT PRESSES :", p1OutputState, p2OutputState);
}

void spTakeControl() {
  p1OutputState = snes1.buttons();
  p2OutputState = snes2.buttons();
  dprint(outputsSwitched);
  dprintState(" SP TAKE CONTROL : ", p1OutputState, p2OutputState);
  if ((p1OutputState & TRIGGER_MASK1) == TRIGGER_MASK1) {
    if (millis() > p1LastTrigger + triggerDebouce) {
      p1LastTrigger = millis();
      outputsSwitched = true;
    }
  }
  else if ((p2OutputState & TRIGGER_MASK1) == TRIGGER_MASK1) {
    if (millis() > p2LastTrigger + triggerDebouce) {
      p2LastTrigger = millis();
      outputsSwitched = true;
    }
  }
  if (outputsSwitched == true) {
    if (p1LastTrigger > p2LastTrigger) {
      p2OutputState = p1OutputState;
      if (millis() > p1LastTrigger + (potVal * 2) + 1500) {
        outputsSwitched = false;
        dprint("BING");
      }
    }
    else {
      p1OutputState = p2OutputState;
      if (millis() > p2LastTrigger + (potVal * 2) + 1500) {
        outputsSwitched = false;
        dprint("BONG");
      }
    }
  }
  else {
    p1OutputState = p2OutputState = p1OutputState | p2OutputState;
  }
  writeToChip(p1OutputState, p2OutputState);
  dprint("OUTPUTS SWITCHED : ");
  dprint(outputsSwitched);
}

uint16_t spPlayerTakeover() {
  player1State = snes1.buttons();
  player2State = snes2.buttons();

  if (player1State & TRIGGER_MASK) {
    player2State = player1State;
  }

  if (player2State & TRIGGER_MASK) {
    player1State = player2State;
  }
  dprint("PLAYER TAKEOVER : ");
  // future improvement :
  // if one player has both trigger held down their controls replace the opponent
  // for 100 ms, then their controls are mixed with their opponents controls for 900ms
}

uint16_t spBothControl() {
  /*
     This function returns any buttons pressed by either controller
  */
  uint16_t output;
  player1State = snes1.buttons();
  player2State = snes2.buttons();
  output = player1State | player2State;
  dprintState("BOTH CONTROL : ", player1State, player2State);
  writeToChip(output, output);
}

uint16_t spPlayersAgree() {
  /*
     In this method the two input controllers are read
     their button states are compared using boolean AND
     and the results of the boolean operation are saved to state
  */
  player1State = snes1.buttons();
  player2State = snes2.buttons();
  p1OutputState = player1State & player2State;
  p2OutputState = p1OutputState;
  dprintState("PLAYERS AGREE :", player1State, player2State);
  writeToChip(p1OutputState, p2OutputState);
}

uint16_t spPlayersAlternate(uint16_t mTurnLength) {
  /*
     This method checks to see who's "turn" it is
     If it is a players turn their controller is read
     and the results are outputed without any manipulation
  */
  uint16_t output;
  player1State = snes1.buttons();
  player2State = snes2.buttons();
  if (millis() > turnStart + turnLengthScaler * potVal) {
    activePlayer = (activePlayer + 1) % 2;
    turnStart = millis();
  }
  if (activePlayer == 0) {
    output = player1State;
  }
  else if (activePlayer == 1) {
    output = player2State;
  }
  if (DEBUG) {
    String status_string = "PLAYERS ALTERNATING : P";
    status_string = status_string + activePlayer + " ";
    dprintState(status_string, player1State, player2State);
  }
  writeToChip(output, output);
}

// ==========================================================================
//                    Multi PLayer Modes of Operation
// ==========================================================================

void mpBothControl() {
  uint16_t alt_mask;
  alt_mask = spPlayersAlternate(turnLength * 2);
  p1OutputState = snes1.buttons() | alt_mask;
  p2OutputState = snes2.buttons() | alt_mask;
  writeToChip(p1OutputState, p2OutputState);
  dprint("MP : ");
}

void mpPressedFirst() {
  temp1 = snes1.buttons();
  temp2 = snes2.buttons();
  p1OutputState = temp1 ^ temp2;
  p2OutputState = temp2 ^ temp1;
  writeToChip(p1OutputState, p2OutputState);
  dprintState("PRESSED FIRST :", p1OutputState, p2OutputState);
}

void mpLimitedPress() {
  p1OutputState = snes1.buttons();
  p2OutputState = snes2.buttons();

  if (p1OutputState ^ p1LastOutputState != 0 && p1OutputState > p1LastOutputState) {
    p1Presses = p1Presses + 1;
    if (p1Presses > 15) {
      p1Does = false;
    }
    if (millis() > lastPressCycle + (potVal * 2 + 1200)) {
      lastPressCycle = millis();
      p1Does = true;
      p1Presses = 0;
    }
  }

  if (p2OutputState ^ p2LastOutputState != 0 && p2OutputState > p2LastOutputState) {
    p2Presses = p2Presses + 1;
    if (p2Presses > 15) {
      p2Does = false;
    }
    if (millis() > lastPressCycle + (potVal * 2  + 1200)) {
      lastPressCycle = millis();
      p2Does = true;
      p2Presses = 0;
    }
  }
  dprint(p1Does);
  dprint(p2Does);
  writeToChip(p1OutputState, p2OutputState);
  dprintln(" ");
  dprintState("LIMITED PRESS :", p1OutputState, p2OutputState);
}

void mpXOR() {
  p1OutputState = snes1.buttons();
  p2OutputState = snes2.buttons();
  temp_mask = p1OutputState & p2OutputState;
  p1OutputState = p1OutputState ^ temp_mask;
  p2OutputState = p2OutputState ^ temp_mask;
  writeToChip(p1OutputState, p2OutputState);
  dprintState("MP XOR :", p1OutputState, p2OutputState);
}

void mpTakeControl() {
  static bool outputsSwitched = false;

  p1OutputState = snes1.buttons();
  p2OutputState = snes2.buttons();
  dprint(outputsSwitched);
  dprintState(" MP TAKE CONTROL : ", p1OutputState, p2OutputState);
  if (p1OutputState & TRIGGER_MASK == TRIGGER_MASK) {
    //Serial.println(" ");
    dprintln(" ");
    if (millis() > p1LastTrigger + triggerDebouce) {
      p1LastTrigger = millis();
      outputsSwitched = true;
    }
  }
  else if (p2OutputState & TRIGGER_MASK == TRIGGER_MASK) {
    //Serial.println(" ");
    dprintln(" ");
    if (millis() > p2LastTrigger + triggerDebouce) {
      p2LastTrigger = millis();
      outputsSwitched = true;
    }
  }
  if (outputsSwitched == true) {
    uint16_t tc_temp = p1OutputState;
    p1OutputState = p2OutputState;
    p2OutputState = tc_temp;
    if (p1LastTrigger > p2LastTrigger)


      //       outputsSwitched=
      //         millis() > (p1LastTrigger > p2LastTrigger ? p1LastTrigger : p2LastTrigger) + potVal * 2 + 800;


      if (millis() > p1LastTrigger + (potVal * 2) + 800) {
        outputsSwitched = false;
      }
      else {
        if (millis() > p2LastTrigger + (potVal * 2) + 800) {
          outputsSwitched = false;
        }
      }
  }
  writeToChip(p1OutputState, p2OutputState);
}

// ==========================================================================
//                Helper Functions for Modes of Operations
// ==========================================================================

void flashLeds() {
  STATUS_LEDS = p1OutputState;
}

// ==========================================================================
//                       Communicating with the SNES('s)
// ==========================================================================

void writeToChip(uint16_t data, uint8_t writtingMode) {
  if (writtingMode == PLAYER_ONE) {
    if (p1LastOutputState != data) {
      PLAYER1_BUTTONS1 = ~(byte)data;
      PLAYER1_BUTTONS2 = ~((data >> 8) | 0x00);
      p1LastOutputState = data;
    }
  }
  else if (writtingMode == PLAYER_TWO) {
    if (p2LastOutputState != data) {
      PLAYER2_BUTTONS1 = ~(byte)data;
      PLAYER2_BUTTONS2 = ~((data >> 8) | 0x00);
      p2LastOutputState = data;
    }
  }
}

void writeToChip(uint16_t player1, uint16_t player2) {
  if (p1LastOutputState != player1) {
    if (MODE == SP_TEAMWORK) {
      PLAYER1_BUTTONS1 = ~(byte)(player1 & (p1OutputMask | p2OutputMask));
      PLAYER1_BUTTONS2 = ~(((player1 & (p1OutputMask | p2OutputMask)) >> 8) | 0x00);
    }
    else if (MODE == MP_LIMITED_PRESS) {
      PLAYER1_BUTTONS1 = ~(byte)(player1 * p1Does);
      PLAYER1_BUTTONS2 = ~(((player1 * p1Does) >> 8) | 0x00);
    }
    else {
      PLAYER1_BUTTONS1 = ~(byte)player1;
      PLAYER1_BUTTONS2 = ~((player1 >> 8) | 0x00);
    }
    p1LastOutputState = player1;
  }
  if (p2LastOutputState != player2) {
    if (MODE == SP_TEAMWORK) {
      PLAYER2_BUTTONS1 = ~(byte)(player2 & (p1OutputMask | p2OutputMask));
      PLAYER2_BUTTONS2 = ~(((player2 & (p1OutputMask | p2OutputMask)) >> 8) | 0x00);
    }
    else if (MODE == MP_LIMITED_PRESS) {
      PLAYER2_BUTTONS1 = ~(byte)(player2 * p2Does);
      PLAYER2_BUTTONS2 = ~(((player2 * p2Does) >> 8) | 0x00);
    }
    else {
      PLAYER2_BUTTONS1 = ~(byte)player2;
      PLAYER2_BUTTONS2 = ~((player2 >> 8) | 0x00);
    }
    p2LastOutputState = player2;
  }
}

// ============================================================
// ------------ Printing and DeBugging ----------------
// ============================================================

void mainLoopDebug() {
  dprint(" : ");
  if (millis() > lastDebug + debugLength) {
    if (MODE == SP_TEAMWORK) {
      dprint(" TW OUTPUTS : ");
      printBits((p1OutputState | p2OutputState) & (p1OutputMask | p2OutputMask));
      dprint(" : ");
      printBits((p2OutputState | p1OutputState) & (p1OutputMask | p2OutputMask));
      dprintln(" ");
    }
    if (MODE == MP_LIMITED_PRESS) {
      dprint(" LP OUTPUTS : ");
      printBits(p1OutputState * p1Does);
      dprint(" : ");
      printBits(p2OutputState * p2Does);
      dprintln(" ");
    }
    else {
      dprint(" OUTPUTS : ");
      printBits(p1OutputState);
      dprint(" : ");
      printBits(p2OutputState);
      dprintln(" ");
    }
    lastDebug = millis();
  }
}

void dprintState(String modeString, uint16_t player1State, uint16_t player2State) {

  if (DEBUG) {
    if (millis() > lastDebug + debugLength) {
      Serial.print(modeString);
      printBits(player1State);
      Serial.print("-");
      printBits(player2State);
      Serial.print(" - ");
    }
  }
}

void printBits(uint16_t myByte) {
  if (millis() > lastDebug + debugLength) {
    for (uint16_t mask = 0x8000; mask; mask >>= 1) {
      if (mask & myByte)
        Serial.print('1');
      else
        Serial.print('0');
    }
  }
}

void printBits(uint8_t myByte) {
  if (millis() > lastDebug + debugLength) {
    for (uint8_t mask = 0x80; mask; mask >>= 1) {
      if (mask & myByte)
        Serial.print('1');
      else
        Serial.print('0');
    }
  }
}

uint16_t buttonSettle(uint16_t myByte) {
  for (uint16_t mask = 0x8000; mask; mask >>= 1) {
    if (mask & myByte)
      return mask;
  }
}

uint8_t countBits(uint16_t myByte) {
  uint8_t bits = 0;
  for (uint16_t mask = 0x8000; mask; mask >>= 1) {
    if (mask & myByte) {
      bits += 1;
    }
  }
  return bits;
}

void dprint(String msg) {
  if (millis() > lastDebug + debugLength) {
    if (DEBUG) {
      Serial.print(msg);
    }
  }
}

void dprint(int msg) {
  if (millis() > lastDebug + debugLength) {
    if (DEBUG) {
      if (msg >= 0) {
        if (msg < 1000) {
          Serial.print(" ");
          if (msg < 100) {
            Serial.print(" ");
            if (msg < 10) {
              Serial.print(" ");
            }
          }
        }
      }
      Serial.print(msg);

    }
  }
}

void dprintln(String msg) {
  if (millis() > lastDebug + debugLength) {
    if (DEBUG) {
      Serial.println(msg);
    }
  }
}

void dprintln(int msg) {
  if (millis() > lastDebug + debugLength) {
    if (DEBUG) {
      Serial.println(msg);
    }
  }
}

void testter() {
  uint16_t on = 0xff;
  uint16_t off = 0x00;
  writeToChip(on, on);
  delay(700);
  writeToChip(off, off);
  delay(700);
}
