nathanshaw/SNES_Circuit_Bending/Firmware/_1_to_4/_1_to_4.ino/_1_to_4.ino.ino

/*
    Arduino Firmware for interfacing with the SNES

    Two Input Controllers : Two Output Controllers

    Programmed by Nathan Villicana-Shaw
    Fall 2015

    This project is a work in progress and builds upon the shoulders
    of many brilliant programmers, hackers, engineers and artists
    (links to be added soon)

    This specific version is for use with the Arduino Shield V1.
    All the pinoutd used in this configuration will be inside the () next to
    the normal values
    

    ===========================================================
    ARDUINO : PORTS AND PINS
    ===========================================================

    -------------------------------------------------
    PLAYER 1 : INPUT
    -------------------------------------------------
    GND
    5v
    DATA          4
    LATCH         2
    CLOCK         3

    -------------------------------------------------
    PLAYER 2 : INPUT
    -------------------------------------------------
    GND
    5v
    DATA          7
    LATCH         5
    CLOCK         6

    -------------------------------------------------
    PLAYER 1 : OUTPUT
    -------------------------------------------------
    PORTA on the Arduino Mega consists of pins 22-29
      22 is bit 0, 29 is bit 7
      we use all the pins  (11111111)

    PORTC on the Arduino MEGA consists of pins 30-37
    `37 is bit 0, 30 is bit 7
      we use pins 34-37 (xxxx1111)

    --------------------------------------------------
    PLAYER 2 : OUTPUT
    -------------------------------------------------
    PORTL : on the Arduino Mega consists of pins 42-49
      49 is bit 0, 42 is bit 7
      we use all the pins (11111111)

    PORTK : on the Arduino Mega consists of analog pins a8-a15
      a8 is bit 0, a15 is bit 7
      we use pins a8-a15 (xxxx1111)

    --------------------------------------------------
    LEDS :
    --------------------------------------------------
    PORTF : on the Arduno Mega port F consists of analog
      pins 0 - 7, each LED corrisponds with an operation mode

    ================================================================================
                                  SNES CONTROLLERS
    ================================================================================

    It is very important to note that the SNES controller reads a button as being pressed
    upon the grounding of its corrisponding pin -  Thus when a 0 is written to a Pin the
    button is "pressed" until the pin is raised back to its HIGH

    When hooking up the SNES controllers there are a few things that help the process :

                  SNES Controller Jack Pins
     ----------------------------- ---------------------
    |                             |                      \
    | (1)     (2)     (3)     (4) |   (5)     (6)     (7) |
    |                             |                      /
     ----------------------------- ---------------------

    Pin   Description   Wire Color
    ===   ===========   ==========
     1    +5v (power)   White
     2    Clock         Yellow
     3    Latch         Orange
     4    Data          Red
     5    Nothing       None
     6    Nothing       None
     7    Ground        Brown

     Data Packing Order for the buttons. Note that the first clock cycle
     is acutually the downwards edge of the LATCH

     Clock Cycle     Button Reported          MEGA PIN Player 1         MEGA PIN Player 2
     ===========     ===============          =================         =================
        1               B                           22                          49
        2               Y                           23                          48
        3               Select                      24                          47
        4               Start - down                25                          46
        5               Up on joypad                26                          45
        6               Down on joypad              27                          44
        7               Left on joypad              28                          43
        8               Right on joypad             29                          42
        9               A                           37                          A8
        10              X                           36                          A9
        11              L                           35                          A10
        12              R                           34                          A11
        13              none (always high)         none                        none
        14              none (always high)         none                        none
        15              none (always high)         none                        none
        16              none (always high)         none                        none

      =======================================================================
                            Mode Selection
      =======================================================================

      for the first four seconds after the Arduino boots
      the board will be in a mode select state

      In order to select an operating mode both players must press one
      of the following buttons as the same time

      A             = players agree
      B             = players alternate
      Y             = players differ
      X             = players both play
      Right Trigger = debug on
      Left Trigger  = debug off
      D-Pad UP      = players alternating random
      D-Pad DOWN    = unmapped
      D-Pad LEFT    = toggler player // needs testing
      D-Pad Right   = two controls two // needs testing
      SELECT        = unmapped
      START         = Turns DEBUG on
      =======================================================================
                                    General Notes
      =======================================================================

      For the SNES controllers the buttons resting position is HIGH as 5v when
      the pad is grounded the button is pressed. This is usally done by bridging
      pads together using conductive plastic that rests on the bottom of the button
      you pressed. In this project we solder wires to the sensing pads that we ground
      using our arduinos digital pins.

      TODO ::

      Flushout the player takeover system
        - perhaps the buttons become the other players D-pad?

       Have different color LEDS for 'single player' and multiplayer modes

*/
// ================================================================
//                           Preprocessor
// ================================================================

#include <SNESpad.h>
// the pins we use for receiving data from the two SNES controllers
#define TRIGGER_MASK 0x0C //bitmask for both of the triggers
// --------------------- Arduino Pins ------------------------
#define SHIELD_VERSION 1
#if SHIELD_VERSION == 1
#define IN1_LATCH 12
#define IN1_CLOCK 13
#define IN1_DATA 11
#define IN2_LATCH 50
#define IN2_CLOCK 10
#define IN2_DATA 51
#endif

#define POT_SIG A15
// --------------------- PORTS -----------------------------
#define PLAYER1_BUTTONS1 PORTA
#define PLAYER1_BUTTONS2 PORTC
#define PLAYER2_BUTTONS1 PORTL
#define PLAYER2_BUTTONS2 PORTK
#define STATUS_LEDS PORTF
// --------------------- MASKS -------------------------------
#define MODE_SELECT_MASK 0x0F03
// ------------------------ MODES ----------------------------
// these variables are use for both switching between the different modes
// as well as applying a bit mask to turn on LED's for user feedback
#define SELECTION_MODE 0x00            // Allows for selecting one of the modes below
#define PLAYERS_AGREE 0x01             // (AND) both players have to press a button
#define PLAYERS_ALTERNATE 0x02         // players take turns
#define PLAYERS_ALTERNATE_RANDOM 0x04  // players take turns of random length
#define PLAYERS_DIFFER 0x08            //  (XOR) if both players press a button it does not go through
#define PLAYERS_BOTH_CONTROL 0x10      //  (OR) both players signal gets passed w/o resistance
#define PLAYERS_DIVERGE 0x20           // (XOR) messages only pass if it is not present in both controllers
#define ONE_TO_FOUR 0xFF
// modes of operation for
// ultimate competative functionality
#define PLAYER_TAKEOVER 0x40           // you are able to "take over" opponent controls
// modes for playing solo
#define TWO_CONTROL_TWO 0x80           // each controller controls each output w/o resistance
// perhaps two_control_two should be an option selected via hardware.
#define TOGGLE_PLAYER 0x81            // you can manually switch between output controllers
// --------------------- Controlers and Players -------------------
// number of players or input controllers
#define NUM_PLAYERS 2

// for chip write modes
#define PLAYER_ONE 1
#define PLAYER_TWO 2

// ================================================================
//                            Globals
// ================================================================
// for dev and debug
int DEBUG = 2;
/*
   0 is no DEBUG
   1 is regular DEBUG - adds print statements
   2 is same as 1 but adds delay to program
*/
// for determining operating mode
int mode = ONE_TO_FOUR;

// dealing with which player is active as well
// as turn durations and lengths
int activePlayer = PLAYER_ONE;
long turnStart = 0;
long pastPoll = 0;
long turnLength = 2000;

long selectPressTime = 1500;
long lastSelectPress = 0;

// for helping with LED flashing
long lastFlash = 0;
int fastFlash = 100;
int slowFlash = 400;

long divergeTurnLength = 1;
int divergeDirection;
int maxDivergeTurnLength = 5000;
// for helping with mode selections
long lastLeftTriggerPress;
long lastRightTriggerPress;
long triggerPressTime = 2000;
long lastLedBlink;

// to keep track of last output sttes
uint16_t p1LastOutputState = 0x0FFF;
uint16_t p1OutputState = 0x0000;
uint16_t p2LastOutputState = 0x0FFF;
uint16_t p2OutputState = 0x0000;
uint32_t p1p2OutputState = 0;

// variable to keep track of past button states
uint16_t player1State = 0x0000;
uint16_t player2State = 0x0000;

// create instances of our SNES controller reader objects
SNESpad snes1 = SNESpad(IN1_LATCH, IN1_CLOCK, IN1_DATA);
SNESpad snes2 = SNESpad(IN2_LATCH, IN2_CLOCK, IN2_DATA);

// =================================================================
//                      Setup and Loop
// =================================================================
void setup() {
  // set controller ports to outputs
  DDRA = 0xFF;
  DDRC = 0xFF;
  DDRL = 0xFF;
  DDRK = 0xFF;
  // set LED's port to output
  DDRF = 0xFF;
  // set pot_pin to input
  pinMode(POT_SIG, INPUT);
  // set controller ports to HIGH (the resting state)
  PLAYER1_BUTTONS1 = 0xFF;
  PLAYER1_BUTTONS2 = 0xFF;
  PLAYER2_BUTTONS1 = 0xFF;
  PLAYER2_BUTTONS2 = 0xFF;
  // set LED's port to LOW
  STATUS_LEDS = 0x00;
  // let things settle
  delay(10);
  // allow players to select a playing mode
  mode = selectMode();
  
  if (DEBUG) {
    Serial.begin(57600);
    Serial.println("SERIAL BUS OPENED");
  }
}


void loop() {
  switch (mode) {
    // -------------------------------------------------
    // Modes for two players playing as one character
    // -------------------------------------------------
    case ONE_TO_FOUR:
      p1p2OutputState = oneToFour();
      simWrite(p1p2OutputState);
      break;
      
    case PLAYERS_AGREE:
      p1OutputState = playersAgree();
      writeToChip(p1OutputState, PLAYER_ONE);
      writeToChip(p1OutputState, PLAYER_TWO);
      break;
      
    case PLAYERS_ALTERNATE:
      p1OutputState = playersAlternate(turnLength);
      writeToChip(p1OutputState, PLAYER_ONE);
      writeToChip(p1OutputState, PLAYER_TWO);
      break;
    
    case PLAYERS_ALTERNATE_RANDOM:
      p1OutputState = playersAlternateRandom(turnLength);
      writeToChip(p1OutputState, PLAYER_ONE);
      writeToChip(p1OutputState, PLAYER_TWO);
      break;
    
    case PLAYERS_DIFFER:
      p1OutputState = playersDiffer();
      writeToChip(p1OutputState, PLAYER_ONE);
      writeToChip(p1OutputState, PLAYER_TWO);
      break;
    
    case PLAYERS_BOTH_CONTROL:
      p1OutputState = bothControl();
      writeToChip(p1OutputState, PLAYER_ONE);
      writeToChip(p1OutputState, PLAYER_TWO);
      break;
    
    case PLAYERS_DIVERGE:
      divergeTurnLength = playersDiverge();
      p1OutputState = playersAlternate(divergeTurnLength);
      writeToChip(p1OutputState, PLAYER_ONE);
      writeToChip(p1OutputState, PLAYER_TWO);
      break;
    
    // same as players both control but output goes to both output controllers
    case TWO_CONTROL_TWO:
      p1OutputState = p2OutputState =  bothControl();
      writeToChip(p1OutputState, PLAYER_ONE);
      writeToChip(p1OutputState, PLAYER_TWO);
      break;
    // -------------------------------------------------
    // Modes for one player play as multiple characters
    // -------------------------------------------------
    case TOGGLE_PLAYER:
      p1OutputState = bothControl();
      activePlayer = determineOutputController();
      writeToChip(p1OutputState, activePlayer);
      break;
    //--------------------------------------------------
    // Modes for two players playing a VS game (KillerInstinct)
    // -------------------------------------------------
    case PLAYER_TAKEOVER:
      playerTakeover();
      writeToChip(player1State, PLAYER_ONE);
      writeToChip(player2State, PLAYER_TWO);
      break;
    // -------------------------------------------------
    // The Selection Mode for switching between all the other modes
    // -------------------------------------------------
    case SELECTION_MODE:
      mode = selectMode();
      break;
      // -----------------------
  }
  // turn on LED's for mode
  if (mode != 0) {
    STATUS_LEDS = mode;
  }
  else if (millis() > lastFlash + slowFlash) {
    STATUS_LEDS = ~STATUS_LEDS;
    lastFlash = millis();
  }
  checkSelect();
  p1LastOutputState = p1OutputState;

  dprint(mode);
  dprint(" : ");
  dprint(" pot value : ");
  dprint(analogRead(POT_SIG));
  dprint(" : ");
  if (DEBUG > 1) { delay(10);};
}

// ==========================================================================
//                               Modes of Operation
// ==========================================================================

uint32_t oneToFour() {
  player1State = snes1.buttons();
  player2State = snes2.buttons();
  uint32_t output = player2State;
 
  return ((uint32_t)player1State << 16 | (uint32_t)player2State);
}

uint16_t playerTakeover() {
  player1State = snes1.buttons();
  player2State = snes2.buttons();

  if (player1State & TRIGGER_MASK) {
    player2State = player1State;
  }

  if (player2State & TRIGGER_MASK) {
    player1State = player2State;
  }
  dprint("PLAYER TAKEOVER : ");
  // future improvement :
  // if one player has both trigger held down their controls replace the opponent
  // for 100 ms, then their controls are mixed with their opponents controls for 900ms
}

uint16_t bothControl() {
  /*
     This function returns any buttons pressed by either controller
  */
  uint16_t output;
  player1State = snes1.buttons();
  player2State = snes2.buttons();
  output = player1State | player2State;
  if (DEBUG) {
    if (mode == PLAYERS_BOTH_CONTROL) {
      Serial.print("BOTH CONTROL : ");
    }
    else if (mode == TWO_CONTROL_TWO) {
      Serial.print("TWO CONTROL TWO : ");
    }
    printBits(player1State);
    Serial.print("-");
    printBits(player2State);
    Serial.print("-OUTPUT-");
    printBits(output);
    Serial.println(" ");
  }
  return output;
}

uint16_t playersAgree() {
  /*
     In this method the two input controllers are read
     their button states are compared using boolean AND
     and the results of the boolean operation are saved to state
  */
  uint16_t output;
  player1State = snes1.buttons();
  player2State = snes2.buttons();
  output = player1State & player2State;

  if (DEBUG) {
    Serial.print("PLAYERS AGREE : ");
    printBits(player1State);
    Serial.print("-");
    printBits(player2State);
    Serial.print("-OUTPUT-");
    printBits(output);
    Serial.println(" ");
  }

  return output;
}

uint16_t playersDiffer() {
  /*
     This method reads both players controller
     and performs an XOR boolean comparison between the
     two controllers. The results are returned as an uint16_t
  */
  uint16_t output;
  player1State = snes1.buttons();
  player2State = snes2.buttons();
  output = player2State ^ player1State;
  if (DEBUG) {
    Serial.print("PLAYERS DIFFER : ");
    printBits(player1State);
    Serial.print("-");
    printBits(player2State);
    Serial.print("-OUTPUT-");
    printBits(output);
    Serial.println(" ");
  }

  return output;
}

int playersDiverge() {
  if ( divergeTurnLength > maxDivergeTurnLength || divergeTurnLength < 0) {
    divergeDirection *= -1;
  }
  divergeTurnLength = divergeTurnLength + divergeDirection;
  return divergeTurnLength;
}

uint16_t playersAlternateRandom(long mTurnLength) {
  /*
     This method checks to see who's "turn" it is
     If it is a players turn their controller is read
     and the results are outputed without any manipulation
  */
  uint16_t output;
  player1State = snes1.buttons();
  player2State = snes2.buttons();
  if (millis() > turnStart + mTurnLength) {
    activePlayer = (activePlayer + 1) % NUM_PLAYERS;
    turnStart = millis();
    dprint("Player");
    dprintln(activePlayer + 1);
    turnLength = mTurnLength * random(200) * 0.01 + (mTurnLength * 0.1);
  }

  if (activePlayer == 0) {
    output = player1State;
  }
  else if (activePlayer == 1) {
    output = player2State;
  }

  if (DEBUG) {
    Serial.print("Players Alernating Random : ");
    printBits(player1State);
    Serial.print("-");
    printBits(player2State);
    Serial.print("-OUTPUT-");
    printBits(output);
    Serial.println(" ");

  }
  return output;
}

uint16_t playersAlternate(long mTurnLength) {
  /*
     This method checks to see who's "turn" it is
     If it is a players turn their controller is read
     and the results are outputed without any manipulation
  */
  uint16_t output;
  player1State = snes1.buttons();
  player2State = snes2.buttons();
  if (millis() > turnStart + mTurnLength) {
    activePlayer = (activePlayer + 1) % NUM_PLAYERS;
    turnStart = millis();
    if (DEBUG) {
      Serial.print("Player : ");
      Serial.println(activePlayer + 1);
    }
  }
  if (activePlayer == 0) {
    output = player1State;
  }
  else if (activePlayer == 1) {
    output = player2State;
  }

  if (DEBUG) {
    Serial.print("PLAYERS ALTERNATING : ");
    printBits(player1State);
    Serial.print("-");
    printBits(player2State);
    Serial.print("-OUTPUT-");
    printBits(output);
    Serial.println(" ");
  }
  return output;
}

// ==========================================================================
// Helper Functions for Modes of Operations
// ==========================================================================
int determineOutputController() {
  /*
       This method allows a single player to toggle
       their signal's output between the two output
       controllers

       this method only responds to the first input controller
       as it assumes you are playing alone
  */
  // check to see if the trigger buttons state has changed
  if (~PLAYER1_BUTTONS2 & TRIGGER_MASK && p1LastOutputState & TRIGGER_MASK) {
    // if it is pressed and the last reading it was not pressed
    // set lastSelectPress to now
    lastSelectPress = millis();
  }
  // if they are off but were just turned on
  else if (!(~PLAYER1_BUTTONS2 & TRIGGER_MASK) && !(p1LastOutputState & TRIGGER_MASK)) {
    // do something
  }
  // if the trigger buttons are held down for select press time flip the activePlayer
  else if (~PLAYER1_BUTTONS2 & TRIGGER_MASK &&
           p1LastOutputState & TRIGGER_MASK &&
           millis() > lastSelectPress + selectPressTime) {
    if (activePlayer = PLAYER_ONE) {
      return PLAYER_TWO;
    }
    else {
      return PLAYER_ONE;
    }
  }
  return activePlayer;
}

int selectMode() {
  /*
    // listen for 5 seconds for a button to have been pressed
    // on both controllers
    // store the last button that is pressed
    // each button corrisponds to an operating mode
  */
  int new_mode = mode;
  uint16_t combined_buttons = snes1.buttons() & snes2.buttons();

  if (combined_buttons & SNES_Y) {
    new_mode = PLAYERS_ALTERNATE;
    if (DEBUG) {
      Serial.println("PLAYERS ALTERNATE SELECTED");
    }
  }
  else if (combined_buttons & SNES_A) {
    new_mode = PLAYERS_AGREE;
    if (DEBUG) {
      Serial.println("PLAYERS AGREE SELECTED");
    }
  }
  else if (combined_buttons & SNES_X) {
    new_mode = PLAYERS_DIFFER;
    if (DEBUG) {
      Serial.println("PLAYERS DIFFER SELECTED");
    }
  }
  else if (combined_buttons & SNES_B) {
    new_mode = PLAYERS_BOTH_CONTROL;
    if (DEBUG) {
      Serial.println("PLAYERS BOTH CONTROL SELECTED");
    }
  }
  else if (combined_buttons &  SNES_UP) {
    new_mode = PLAYERS_ALTERNATE_RANDOM;
    if (DEBUG) {
      Serial.println("PLAYERS ALTERNATE RANDOM SELECTED");
    }
  }
  else if (combined_buttons & SNES_R) {
    DEBUG = true;
    if (DEBUG) {
      Serial.println("DEBUG TURNED ON");
    }
  }
  else if (combined_buttons & SNES_L) {
    if (DEBUG) {
      Serial.println("DEBUG TURNED OFF");
    }
    DEBUG = false;
  }
  else if (combined_buttons & SNES_DOWN) {
    new_mode = PLAYERS_DIVERGE;
    if (DEBUG) {
      Serial.println("PLAYERS DIVERGE");
    }
  }
  else if (combined_buttons & SNES_LEFT) {
    new_mode = TOGGLE_PLAYER;
    if (DEBUG) {
      Serial.println("TOGGLE PLAYER SELECTED");
    }
  }
  else if (combined_buttons & SNES_RIGHT) {
    new_mode = TWO_CONTROL_TWO;
    dprintln("TWO CONTROL TWO SELECTED");
  }
  return new_mode;
}

void moveJoystick(int delayTime) {
  // this is to tell the players that the process is finished
  PLAYER1_BUTTONS1 = PLAYER1_BUTTONS1 = ~SNES_UP;
  delay(delayTime);
  PLAYER1_BUTTONS1 = PLAYER1_BUTTONS1 = 0xFF;
  PLAYER1_BUTTONS1 = PLAYER1_BUTTONS1 = ~SNES_DOWN;
  delay(delayTime);
  PLAYER1_BUTTONS1 = PLAYER1_BUTTONS1 = 0xFF;
  PLAYER1_BUTTONS1 = PLAYER1_BUTTONS1 = ~SNES_LEFT;
  delay(delayTime);
  PLAYER1_BUTTONS1 = PLAYER1_BUTTONS1 = ~0xFF;
  PLAYER1_BUTTONS1 = PLAYER1_BUTTONS1 = ~SNES_RIGHT;
  delay(delayTime);
  PLAYER1_BUTTONS1 = PLAYER1_BUTTONS1 = 0xFF;
  p1OutputState = p1LastOutputState = 0x0000;
  player1State = player2State = 0x0000;
}

// ==========================================================================
//                       Communicating with the SNES('s)
// ==========================================================================

void writeToChip(uint16_t data, int writtingMode) {
  if (writtingMode == PLAYER_ONE) {
    PLAYER1_BUTTONS1 = ~(byte)data;
    PLAYER1_BUTTONS2 = ~((data >> 8) | 0x00);
    p1LastOutputState = data;
  }
  else if (writtingMode == PLAYER_TWO) {
    PLAYER2_BUTTONS1 = ~(byte)data;
    PLAYER2_BUTTONS2 = ~((data >> 8) | 0x00);
    p2LastOutputState = data;
  }
}


void simWrite(uint32_t p1p2Output) {
  uint16_t p1Output = (uint16_t)(p1p2Output >> 16);
  uint16_t p2Output = (uint16_t)(p1p2Output & 0x0000FFFF);
  int chance = random(0,2);
  
    if (chance == 0) {
      writeToChip(p1Output, PLAYER_ONE);
      writeToChip(p2Output, PLAYER_TWO);
    }
    else {
      writeToChip(p2Output, PLAYER_TWO);
      writeToChip(p1Output, PLAYER_ONE);
    }
}

void checkSelect() {
  /*
     This method enters into the selection mode if the
     select button is held down for selectPressTime
  */
  
  // check to see if the select buttons state has changed
  if (p1OutputState & SNES_SELECT && !(p1LastOutputState & SNES_SELECT)) {
    // if it is pressed and the last reading it was not pressed
    // set lastSelectPress to now
    lastSelectPress = millis();
    // DEACTIVATED!!!
  }
  else if (p1OutputState & SNES_SELECT &&
           p1LastOutputState & SNES_SELECT &&
           millis() > lastSelectPress + selectPressTime) {
    // press start and enter selection mode
    // DEACTIVATED
    // moveJoystick(100);
    // mode = SELECTION_MODE;
  }
  /*
  if (p1LastOutputState & MODE_SELECT_MASK == MODE_SELECT_MASK ||
    p2LastOutputState & MODE_SELECT_MASK == MODE_SELECT_MASK) {
      mode = SELECTION_MODE;
    }
   */
}

// ============================================================
// ------------ Printing and DeBugging ----------------
// ============================================================

void printBits(uint16_t myByte) {
  for (uint16_t mask = 0x8000; mask; mask >>= 1) {
    if (mask  & myByte)
      Serial.print('1');
    else
      Serial.print('0');
  }
}

void dprint(String msg) {
  if (DEBUG) {
    Serial.print(msg);
  }
}

void dprint(int msg) {
  if (DEBUG) {
    Serial.print(msg);
  }
}

void dprintln(String msg) {
  if (DEBUG) {
    Serial.println(msg);
  }
}

void dprintln(int msg) {
  if (DEBUG) {
    Serial.println(msg);
  }
}
