nathanshaw/SNES_Circuit_Bending/(commit log)

2015-11-13 initial commit, eagle boards and arduino code
    [nano_control_station.brd, nano_control_station.sch]
2015-12-16 added more defines for port names for readability, created player 1 and player 2 variables for current and past output data.
2015-12-17 added dprint and dprintln functions for debug printing to try and clean things up
2015-12-18 added eagle files for ultimate co-op arduino mega shield
    [ultimate_Co-Op_v1_0.brd, ultimate_Co-Op_v1_0.sch]
2016-01-05 new version of the board for the SNES that accounts for the five pins on the controllers and a a few other minor other mistakes
    [nano_control_station.brd, nano_control_station.sch, ultimate_Co-Op_v1_0.brd, ultimate_Co-Op_v1_0.sch]
2016-01-06 created a 'mini' version of the co-op board
    [ultimate_Co-Op_v1_0.brd, ultimate_Co-Op_v1_0.sch]
2016-01-06 created a 'mini' version of the co-op board again...
    [ultimate_Co-Op_v1_0.brd]
2016-01-09 added folder for keeping track of invoices related to project and created code for the 1 to 4 project
2016-01-17 reworked LED code a little and started expanding on the shield
    [ultimate_Co-Op_v1_2.brd, ultimate_Co-Op_v1_2.sch]
2016-01-18 added snes schematic to the repo
2016-01-24 a few minor changes to the board, now has one rotaty and one switch
    [ultimate_Co-Op_v1_2.brd]
2016-02-03 added updates to the ultimate co-op shield
    [ultimate_Co-Op_v2_0.brd, ultimate_Co-Op_v2_0.sch]
2016-02-05 added POC code for the automatic switcher
2016-02-24 added better multiplayer modes, got rid of players diverge, added normal modes, added counting of button presses
2016-02-26 removed two old projects that are no longer current
2016-02-27 renamed modular snes shield file
    [nano_control_station.brd, nano_control_station.sch]
2016-02-29 moved printing out of the modular SNES main code
